felipegaspari/DCO4-REBORN-DCO/docs/AUTOTUNE.md

# Autotune (DCO4-REBORN)

Canonical algorithms and file layout: [`../_shared/docs/AUTOTUNE.md`](../_shared/docs/AUTOTUNE.md).
Operator bring-up: [`../_shared/docs/CALIBRATION_PROCEDURE.md`](../_shared/docs/CALIBRATION_PROCEDURE.md).

This board: **4 voices × 2 oscillators** (8 osc), four PW channels (`cal_pw_channel` = osc / 2), cal-sense **GP10**. Debug cmd 42 is still forwarded to the Mainboard.
