felipegaspari/DCO4-REBORN-DCO/docs/BUILD_FLAGS.md

# DCO Build Flags Catalog

Complete inventory of **live compile-time flags** that change codegen, RAM, IO, or A/B math paths.

- **Deep float/fixed math:** [`ENGINE_OPTIONS.md`](ENGINE_OPTIONS.md)
- **Profiler usage:** [`BENCHMARKING.md`](BENCHMARKING.md)
- **SRAM / heap / stack:** [`MEMORY.md`](MEMORY.md) (`__not_in_flash_func`, dump cmd 13, pin policy)
- **Autotune algorithms:** [`../_shared/docs/AUTOTUNE.md`](../_shared/docs/AUTOTUNE.md)
- **Live source of truth for engine/IO/cal toggles:** top of [`../DCO.ino`](../DCO.ino) before includes

**Override order:** flags set in `DCO.ino` before `#include` win. Header `#ifndef` / library fallbacks apply only when the sketch left them unset.

**Out of scope here:** include guards, X-macro / dirty-bit / note-frequency tables, `_removed/`, MIDI_Library / PID examples. [`../tusb_config.h`](../tusb_config.h) exists but is **not included** (commented in `DCO.ino` / `include_all.h`).

---

## Shipping snapshot

Board defaults in `DCO.ino` differ by MCU (`PICO_RP2350` vs else). The overrides block after that can force either shape.

| Area | RP2350 | RP2040 |
|---|---|---|
| Voice / amp | `USE_FLOAT_VOICE_TASK` + `USE_FLOAT_AMP_COMP` | Fixed (`USE_FLOAT_*` undefined) |
| Pitch | `PITCH_INTERP_FLOAT_FAST` | `PITCH_INTERP_RATIO_Q16` |
| Amp method default | `0` (`FLOAT_QUAD`) | `2` (`FIXED`) |
| Clkdiv | `CLKDIV_FLOAT` | `CLKDIV_Q16` |
| CV outs | Fixed (`USE_FLOAT_CV_OUTS` off) | same |
| Noise | `NOISE_ENGINE 1`, `ENABLE_NOISE_OUT` off | same |
| Autotune | FREQ_TRACE / INTERP / CALC (`AUTOTUNE_*_DEFAULT` = 1) | same |
| ADSR | fixed Q22 phase, micros, native Q15 | same |
| USB panel | `ENABLE_USB_CONTROL` on | same |
| Mainboard UART | `ENABLE_MAINBOARD_LINK` on; `ENABLE_MB_MOD_STREAM` off | same |
| CV / mux / aux HW | off (`ENABLE_CV_OUTS` / `WAVE_MUX` / `VOICE_AUX` commented) — **retained**, unused on this 4×2 board. PW PWM is independent (always live). | same |
| PIO RESET | `ENABLE_PIO_RESET_INVERT` on | same |
| RANGE amp PWM | `RANGE0_PIO_DITHER_TEST` **off** (HW slice; dither not feasible for 8 oscs) | same |
| Profiler (tree as checked in) | `RUNNING_AVERAGE` + `RUNNING_AVERAGE_PERIOD` on; FINE off; `BENCH_STAGE_STRIDE` 1; `BENCH_PERIOD_MAX_US` 20000 | same |
| Mem diag (dump 13) | `ENABLE_MEM_DIAG` on; runtime polls on | same |

Confirm with the `engine:` / `io:` lines in the profiler banner ([`bench.h`](../bench.h)).

---

## 1. [`DCO.ino`](../DCO.ino) — before includes

### 1.1 Engine — pitch mode ids

| Define | Value | Role |
|---|---:|---|
| `PITCH_INTERP_FLOAT` | 0 | Walk-find float interp (needs float voice) |
| `PITCH_INTERP_RATIO_Q16` | 1 | Native Q16 slope path (shipping) |
| `PITCH_INTERP_Q12` | 2 | Legacy ×10000 slope A/B |
| `PITCH_INTERP_FLOAT_FAST` | 3 | Trunc+clamp±1 float find (needs float voice) |

### 1.2 Engine — board defaults (`PICO_RP2350` / else)

| Define | RP2350 | RP2040 | Effect | Consumed |
|---|---|---|---|---|
| `USE_FLOAT_VOICE_TASK` | **on** | off | Compile `voice_task_float` instead of fixed | [`voices.h`](../voices.h) / [`voices.ino`](../voices.ino) |
| `USE_FLOAT_AMP_COMP` | **on** | off | Float amp tables + LUT (`NUM_OSCILLATORS × 7001 × 2` bytes; ~109 KB at 8 osc) dual-build | [`amp_comp.h`](../amp_comp.h), [`FS.ino`](../FS.ino) |
| `AMP_COMP_METHOD_DEFAULT` | `0` (FLOAT_QUAD) | `2` (FIXED) | Initial `amp_comp_method` | [`amp_comp.h`](../amp_comp.h), runtime cmds 20–22 |
| `PITCH_INTERP_MODE` | `PITCH_INTERP_FLOAT_FAST` | `PITCH_INTERP_RATIO_Q16` | Selects one interpolator + its tables | [`voices.ino`](../voices.ino), pitch benches |
| `CLKDIV_MODE` | `CLKDIV_FLOAT` (`1`) | `CLKDIV_Q16` (`2`) | Clkdiv (accuracy order): `0` GOLD (double `llround`); `1` FLOAT (Q24 → float Hz / native Hz on float voice); `2` Q16; `3` Q8 (Q8 32/32+corr); `4` FAST_Q4 (Q4 32/32). Value `0` is GOLD, not old HP0. Value `1` is FLOAT, not old PRECISE_Q8. Both voice engines: fixed via `clkdiv_live_total_cycles`, float via `clkdiv_live_hz_total_cycles`. Cmds 32–33 A/B all five live + GOLD_REF. | `voice_task_fixed_point` / `voice_task_float`, [`clkdiv.h`](../clkdiv.h), [`clkdiv_bench.ino`](../clkdiv_bench.ino) |

`USE_FLOAT_CV_OUTS` is **not** a board default (enable only in overrides). Math detail: [`ENGINE_OPTIONS.md`](ENGINE_OPTIONS.md).

### 1.3 Engine — overrides (commented A/B)

The overrides block is commented in the tree. RP2350 already enables float voice/amp via §1.2; uncomment here to force a path on RP2040 or to A/B clkdiv / pitch / amp method.

| Define | Overrides block | Effect | Consumed |
|---|---|---|---|
| `USE_FLOAT_VOICE_TASK` | commented | Compile `voice_task_float` instead of fixed | [`voices.h`](../voices.h) / [`voices.ino`](../voices.ino) |
| `USE_FLOAT_AMP_COMP` | commented | Float amp tables + LUT (`NUM_OSCILLATORS × 7001 × 2` bytes; ~109 KB at 8 osc) dual-build | [`amp_comp.h`](../amp_comp.h), [`FS.ino`](../FS.ino) |
| `USE_FLOAT_CV_OUTS` | commented | Float VCA/VCF/keytrack/drift path | [`cv_out.ino`](../cv_out.ino), [`cv_state.h`](../cv_state.h) |

Pitch A/B: `#undef PITCH_INTERP_MODE` then redefine. Guard: `FLOAT` / `FLOAT_FAST` without float voice → `#error`.

### 1.4 Noise

| Define | Shipping | Effect | Consumed |
|---|---|---|---|
| `NOISE_ENGINE` | `1` (FastNoiseGen) | Which `DcoNoiseGen` implementation | [`noise.h`](../noise.h), [`DCO_Noise.h`](../_build_libs/DCO_Noise/DCO_Noise.h) |
| `ENABLE_NOISE_OUT` | off | PIO1 LFSR 1-bit white on GP2 | DCO_Noise, [`state_machines.ino`](../state_machines.ino) |

`NOISE_ENGINE` values: `0` ColoredNoise, `1` FastNoiseGen, `2` PrimeHybridNoise, `3` ProNoise32.

### 1.5 Profiling / bench

| Define | Shipping | Effect | Consumed |
|---|---|---|---|
| `RUNNING_AVERAGE` | **on** | Hot-path profiler (`bench.h`); paced `bench_out_*` | [`bench.h`](../bench.h), benches |
| `RUNNING_AVERAGE_FINE` | off | Extra tiny-stage probes (opt barrier) | `BENCH_FBEGIN` / `FEND` |
| `RUNNING_AVERAGE_PERIOD` | **on** | Period probes only; stage probes compile out; overrides FINE | `bench.h` |
| `BENCH_STAGE_STRIDE` | `1` | MAIN/FINE stage probes every Nth loop (`1` = every iter); note-on always; needs `RUNNING_AVERAGE` | [`bench.h`](../bench.h), [`DCO.ino`](../DCO.ino) |
| `BENCH_USE_SYSTICK` | `1` | SysTick for PERIOD + stages; `0` → 1 µs timer for all probes. Dump window still 1 µs. | [`bench.h`](../bench.h), [`DCO.ino`](../DCO.ino) |
| `BENCH_PERIOD_MAX_US` | `20000` | Discard PERIOD samples longer than this (autotune / wrap-looking stalls) | [`bench.h`](../bench.h), [`DCO.ino`](../DCO.ino) |
| `BENCH_PATH_STATS` | off | All path bumps + `-- Path counters --` dump; needs `RUNNING_AVERAGE`; no-op under PERIOD | [`bench.h`](../bench.h), [`voices.ino`](../voices.ino) |
| `AMP_COMP_BENCHMARK` | off | Amp speed/accuracy cmds 24–25; needs `RUNNING_AVERAGE` + `USE_FLOAT_AMP_COMP` | [`amp_comp_bench.ino`](../amp_comp_bench.ino) |
| `ENABLE_MEM_DIAG` | **on** | Cmd 13 RAM dump + `loop`/`loop1` polls; comment out = empty inlines. Runtime 14/15 disable/enable polls | [`mem_diag.h`](../mem_diag.h), [`MEMORY.md`](MEMORY.md) |

Pitch interp cmds **28–29** and fixed clkdiv cmds **32–33** (`CLKDIV_MODE` A/B) need `RUNNING_AVERAGE` only (no extra flag): [`pitch_interp_bench.ino`](../pitch_interp_bench.ino), [`clkdiv_bench.ino`](../clkdiv_bench.ino).

### 1.6 Calibration (auto-cal boot defaults)

Set in `DCO.ino` before includes. Enums and `#ifndef` fallbacks live in [`_shared/autotune.h`](../_shared/autotune.h). Algorithms: [`../_shared/docs/AUTOTUNE.md`](../_shared/docs/AUTOTUNE.md).

| Define | Shipping | Effect | Consumed |
|---|---|---|---|
| `AUTOTUNE_AMP_METHOD_DEFAULT` | `1` (FREQ_TRACE) | Amp-comp calibration search: `0` CLASSIC (per-note range-PWM search), `1` FREQ_TRACE (fixed-PWM frequency bisection from the manual 440 Hz anchor). Runtime 34/35 (panel Calibration tab); reported as `amp_cal=` on the profiler `engine:` line. Header fallback is `0` if this is unset. | [`DCO.ino`](../DCO.ino), [`_shared/autotune.h`](../_shared/autotune.h) |
| `AUTOTUNE_SEARCH_MODE_DEFAULT` | `1` (INTERP) | How the frequency search closes in once it has a bracket: `0` BISECT, `1` INTERP, `2` GATED. Runtime 37/38/39. Header fallback is also `1`. | [`DCO.ino`](../DCO.ino), [`_shared/autotune.h`](../_shared/autotune.h) |
| `AUTOTUNE_AMP0_MODE_DEFAULT` | `1` (CALC) | Amp-comp-0 endpoint (pair 0): `0` MEASURE (live hunt), `1` CALC (bottom-rung fit). Runtime 40/41. Header fallback is `0` if this is unset. | [`DCO.ino`](../DCO.ino), [`_shared/autotune.h`](../_shared/autotune.h) |

### 1.7 Board / IO

| Define | Shipping | Effect | Consumed |
|---|---|---|---|
| `ENABLE_MAINBOARD_LINK` | **on** | Serial2 GP20/21 peers with the STM32 Mainboard (`'n'`/`'o'`/`'e'`/`'x'`/`'p'` TX; slim `'p'` RX) | [`Serial.h`](../Serial.h) / [`Serial.ino`](../Serial.ino) |
| `ENABLE_MB_MOD_STREAM` | **off** | Consume Mainboard `'m'` and skip local LFO1/2 + EnvDCO clocks. Default off: DCO runs LFO1/2, envelopes, and matrix→pitch locally. | [`Serial.ino`](../Serial.ino), [`voices.ino`](../voices.ino), [`DCO.ino`](../DCO.ino) `loop()` |
| `ENABLE_USB_CONTROL` | **on** | Panel protocol on USB CDC (`dco_control`) | [`Serial.h`](../Serial.h) / [`Serial.ino`](../Serial.ino), bench TX |
| `SERIAL_FRAMING_COBS` | **off** | On-wire COBS(`inner`)+`0x00` instead of RAW inner. A/B vs default; host: `dco_control --cobs` or `DCO_SERIAL_COBS=1`. | [`serial_frame.h`](../serial_frame.h) / [`serial_parser.h`](../serial_parser.h), [`DCO.ino`](../DCO.ino) |
| `ENABLE_CV_OUTS` | off | Cut/Res/VCA/dist/levels PWM writers — unused on this project; keep for expansion. PW is not behind this flag. | [`PWM.ino`](../PWM.ino), [`cv_out.ino`](../cv_out.ino), [`globals.h`](../globals.h) pins |
| `ENABLE_WAVE_MUX` | off | Wave mux GPIO / shift-register — unused on this project; keep for expansion | globals pin block, wave mux |
| `ENABLE_VOICE_AUX` | off | Skip local Dist/filter writers (aux owns them) | [`PWM.ino`](../PWM.ino), globals |
| `ENABLE_PIO_RESET_INVERT` | **on** | Active-low RESET pad via GPIO OVER | [`state_machines.ino`](../state_machines.ino) |
| `RANGE0_PIO_DITHER_TEST` | **off** | Comment out = HW slice `wrap=DIV_COUNTER` on all 8 `RANGE_PINS[]`. Define = PIO dither (not used on 4×2). | [`PWM.h`](../PWM.h) / [`PWM.ino`](../PWM.ino), [`_shared/autotune_impl.h`](../_shared/autotune_impl.h), `setup1()` |
| `NOTE_RETRIG_MODE_DEFAULT` | `0` (EXACT_Y) | Note-on sync retrig default; runtime 26/27 | [`globals.h`](../globals.h) |

---

## 2. [`adsr.h`](../adsr.h) → [`ADSR_Bezier.h`](../_build_libs/ADSR_Bezier/ADSR_Bezier.h)

Sketch sets these **before** including the library (library has its own fallbacks).

| Define | DCO shipping | Library fallback if unset | Effect |
|---|---:|---|---|
| `ADSR_BEZIER_PHASE_SHIFT` | `22` | `22` | `22` = uint32 phase; `>22` (e.g. 24) = uint64 phase |
| `ADSR_BEZIER_USE_FLOAT` | `0` | `0` | `1` = float time index (soft-float on RP2040) |
| `ADSR_BEZIER_USE_MICROS` | `1` | `1` | `1` micros / `0` millis timebase |
| `ADSR_BEZIER_NATIVE_Q15` | `1` | **`0`** | `1` = primary amp domain Q15; `0` = DAC-primary + optional cache |
| `ADSR_BEZIER_Q15_DYADIC` | `1` | `1` | NATIVE=1: peak 32768 vs 32767 A/B |
| `ADSR_BEZIER_UPDATE_Q15_CACHE` | `1` | `1` | Refresh Q15 in `getWave`; ignored when NATIVE=1 |
| `ADSR_BEZIER_SRAM_HOT` | **`1`** | **`0`** | `1` = RP2040 `__not_in_flash_func` on `getWave` / `noteOn` / `noteOff` (static SRAM, not heap — [`MEMORY.md`](MEMORY.md)) |

Derived: `ADSR_BEZIER_PHASE_SCALE_U64` (`1` when shift > 22).

---

## 3. [`LFO.h`](../LFO.h) → [`mo-lfo.h`](../_build_libs/mo-lfo/mo-lfo.h)

| Define | DCO shipping | Library fallback if unset | Effect |
|---|---:|---|---|
| `MO_LFO_USE_Q15` | `1` | **`0`** | Preferred-path hint / pragma only; API always has `getWave` + `getWaveQ15` |
| `MO_LFO_SRAM_HOT` | **`1`** | **`0`** | `1` = RP2040 `__not_in_flash_func` on `getWaveQ15` + `_advanceUnitQ15` (static SRAM — [`MEMORY.md`](MEMORY.md)) |
| `LFO_SINE_TABLE_BITS` | `9` | `9` (in mo-lfo if unset) | Sine LUT size `1<<bits` |

---

## 4. [`globals.h`](../globals.h)

### Feature flags

| Define | Shipping | Effect | Consumed |
|---|---|---|---|
| `ENABLE_FS_CALIBRATION` | **on** | Load LittleFS `voiceTables` / PW cal into amp-comp | [`FS.ino`](../FS.ino) |
| `NOTE_RETRIG_MODE_DEFAULT` | `0` if unset | Fallback if `DCO.ino` omitted it | `note_retrig_mode` |
| `USE_ADC_STACK_VOICES` | commented | Legacy ADC stack voices (GPIO 28) | unused when commented |
| `USE_ADC_DETUNE` | commented | Legacy ADC detune (GPIO 27) | unused when commented |

**LittleFS flash partition:** presets (`pb00`…`pb63`, 4 records × 598 B per chunk) plus
calibration files need a filesystem slice. The default
`rp2040:rp2040:rpipico2:usbstack=tinyusb` FQBN often allocates **no** FS space.
Compile/upload with an explicit size that includes one, e.g.:

```bash
arduino-cli compile \
  --fqbn rp2040:rp2040:rpipico2:usbstack=tinyusb,flash=4194304_524288 \
  --libraries ./_build_libs \
  .
```

(`4194304_524288` = 4 MB flash, 512 KB LittleFS — sized for a full 256-slot bank at
4 records/file.) Without that, `init_FS()` / preset save fail at runtime. Changing the
FS size moves `_FS_start`/`_FS_end` and **reformats the filesystem** — back up
calibration + presets with `tools/dco_control` first, restore after. Preset
protocol: [`PRESET_STORE.md`](PRESET_STORE.md).

Comment-only (not a live define): `ENABLE_PIO_MIDI` — PIO2 reserved in comments / [`PINOUT.md`](PINOUT.md); not compiled today.

### Capacity constants (not feature toggles)

| Define | Value | Role |
|---|---:|---|
| `NUM_VOICES_TOTAL` | 4 | MIDI voice-slot capacity (ADSR / flags / PW) |
| `NUM_OSCILLATORS` | 8 | Physical DCOs (2 per voice) |
| `NUM_PW_CHANNELS` | 4 (`NUM_VOICES_TOTAL`) | PW PWM channels; `cal_pw_channel(osc)` = osc / 2 |
| `NUM_FILTERS` | 2 (`#ifndef`) | Filter count (also defaulted in `cv_out.h` / `PWM.h` / `cv_state.h`) |
| `MIDI_CHANNEL` | 1 | Default MIDI channel |

---

## 5. Other live headers

| File | Define | Shipping | Effect |
|---|---|---|---|
| [`noise.h`](../noise.h) | `NOISE_ENGINE` | fallback `0` if sketch omit | DCO sets `1` in `DCO.ino` |
| [`bench.h`](../bench.h) | `BENCH_USE_SYSTICK` / `BENCH_PERIOD_MAX_US` | sketch wins | Header `#ifndef` fallbacks only if unset in [`DCO.ino`](../DCO.ino) |
| [`amp_comp.h`](../amp_comp.h) | `AMP_COMP_METHOD_DEFAULT` | fallback `AMP_COMP_FIXED` | Only if unset before include |
| [`_shared/autotune.h`](../_shared/autotune.h) | `AUTOTUNE_AMP_METHOD_DEFAULT` / `SEARCH` / `AMP0` | sketch wins (`1`/`1`/`1`); header fallback `0`/`1`/`0` | Only if unset before include |
| [`voices.ino`](../voices.ino) | `DCO_DEBUG_REPORT` | `0` | `1` = serial dump of OSC1 frequency stages |

Headers that only **consume** flags (no new feature `#define`): `voices.h`, `cv_state.h`, `cv_out.h`, `PWM.h`, `Serial.h`, `FS.h`, `mod_matrix.h`, `include_all.h`, etc.

---

## 6. Vendored library notes

| Library | Flag interaction |
|---|---|
| ADSR_Bezier | Defaults differ on `NATIVE_Q15` (`0` in lib vs `1` in DCO) and `SRAM_HOT` (`0` vs `1`). Always set via [`adsr.h`](../adsr.h). |
| mo-lfo | `MO_LFO_USE_Q15` / `MO_LFO_SRAM_HOT` lib default `0`; DCO forces `1` in [`LFO.h`](../LFO.h). |
| DCO_Noise | Reads `NOISE_ENGINE` / `ENABLE_NOISE_OUT`; fallback engine `0`. |

---

## 7. Where to change what

| Goal | Where |
|---|---|
| Float/fixed voice, pitch, amp, CV, HP clkdiv | `DCO.ino` **ENGINE — overrides** (and board defaults for MCU policy) |
| Autotune method / search / amp-0 boot defaults | `DCO.ino` **CALIBRATION** block (`AUTOTUNE_*_DEFAULT`) |
| Noise engine / PIO white pin | `DCO.ino` noise block |
| Profiler on/off / period-only | `DCO.ino` profiling block |
| USB panel / Mainboard UART / CV HW / aux / RESET invert | `DCO.ino` BOARD / IO |
| ADSR phase / native Q15 / SRAM hot A/B | [`adsr.h`](../adsr.h) before library include |
| LFO Q15 hint / SRAM hot / sine table bits | [`LFO.h`](../LFO.h) |
| Heap / stack / RAM-text dump | Diagnostics cmd **13**; polls flag `ENABLE_MEM_DIAG` + runtime 14/15 — [`MEMORY.md`](MEMORY.md) |
| FS cal load | [`globals.h`](../globals.h) `ENABLE_FS_CALIBRATION` |
| OSC1 debug prints | [`voices.ino`](../voices.ino) `DCO_DEBUG_REPORT` |

After flag changes: clean rebuild; confirm LittleFS amp-comp load; listen low notes + amp plateau; optional profiler dump (cmd **10**) — see [`BENCHMARKING.md`](BENCHMARKING.md).
