felipegaspari/DCO4-REBORN-DCO/docs/CALIBRATION_PROCEDURE.md

# Calibration procedure (DCO4-REBORN)

Canonical operator workflow: [`../_shared/docs/CALIBRATION_PROCEDURE.md`](../_shared/docs/CALIBRATION_PROCEDURE.md).
Algorithms: [`../_shared/docs/AUTOTUNE.md`](../_shared/docs/AUTOTUNE.md).

This board: oscillators **0..7**, four PW channels, cal-sense **GP10**.
