felipegaspari/DCO4-REBORN-DCO/docs/schematics/distortion/distortion.pdf

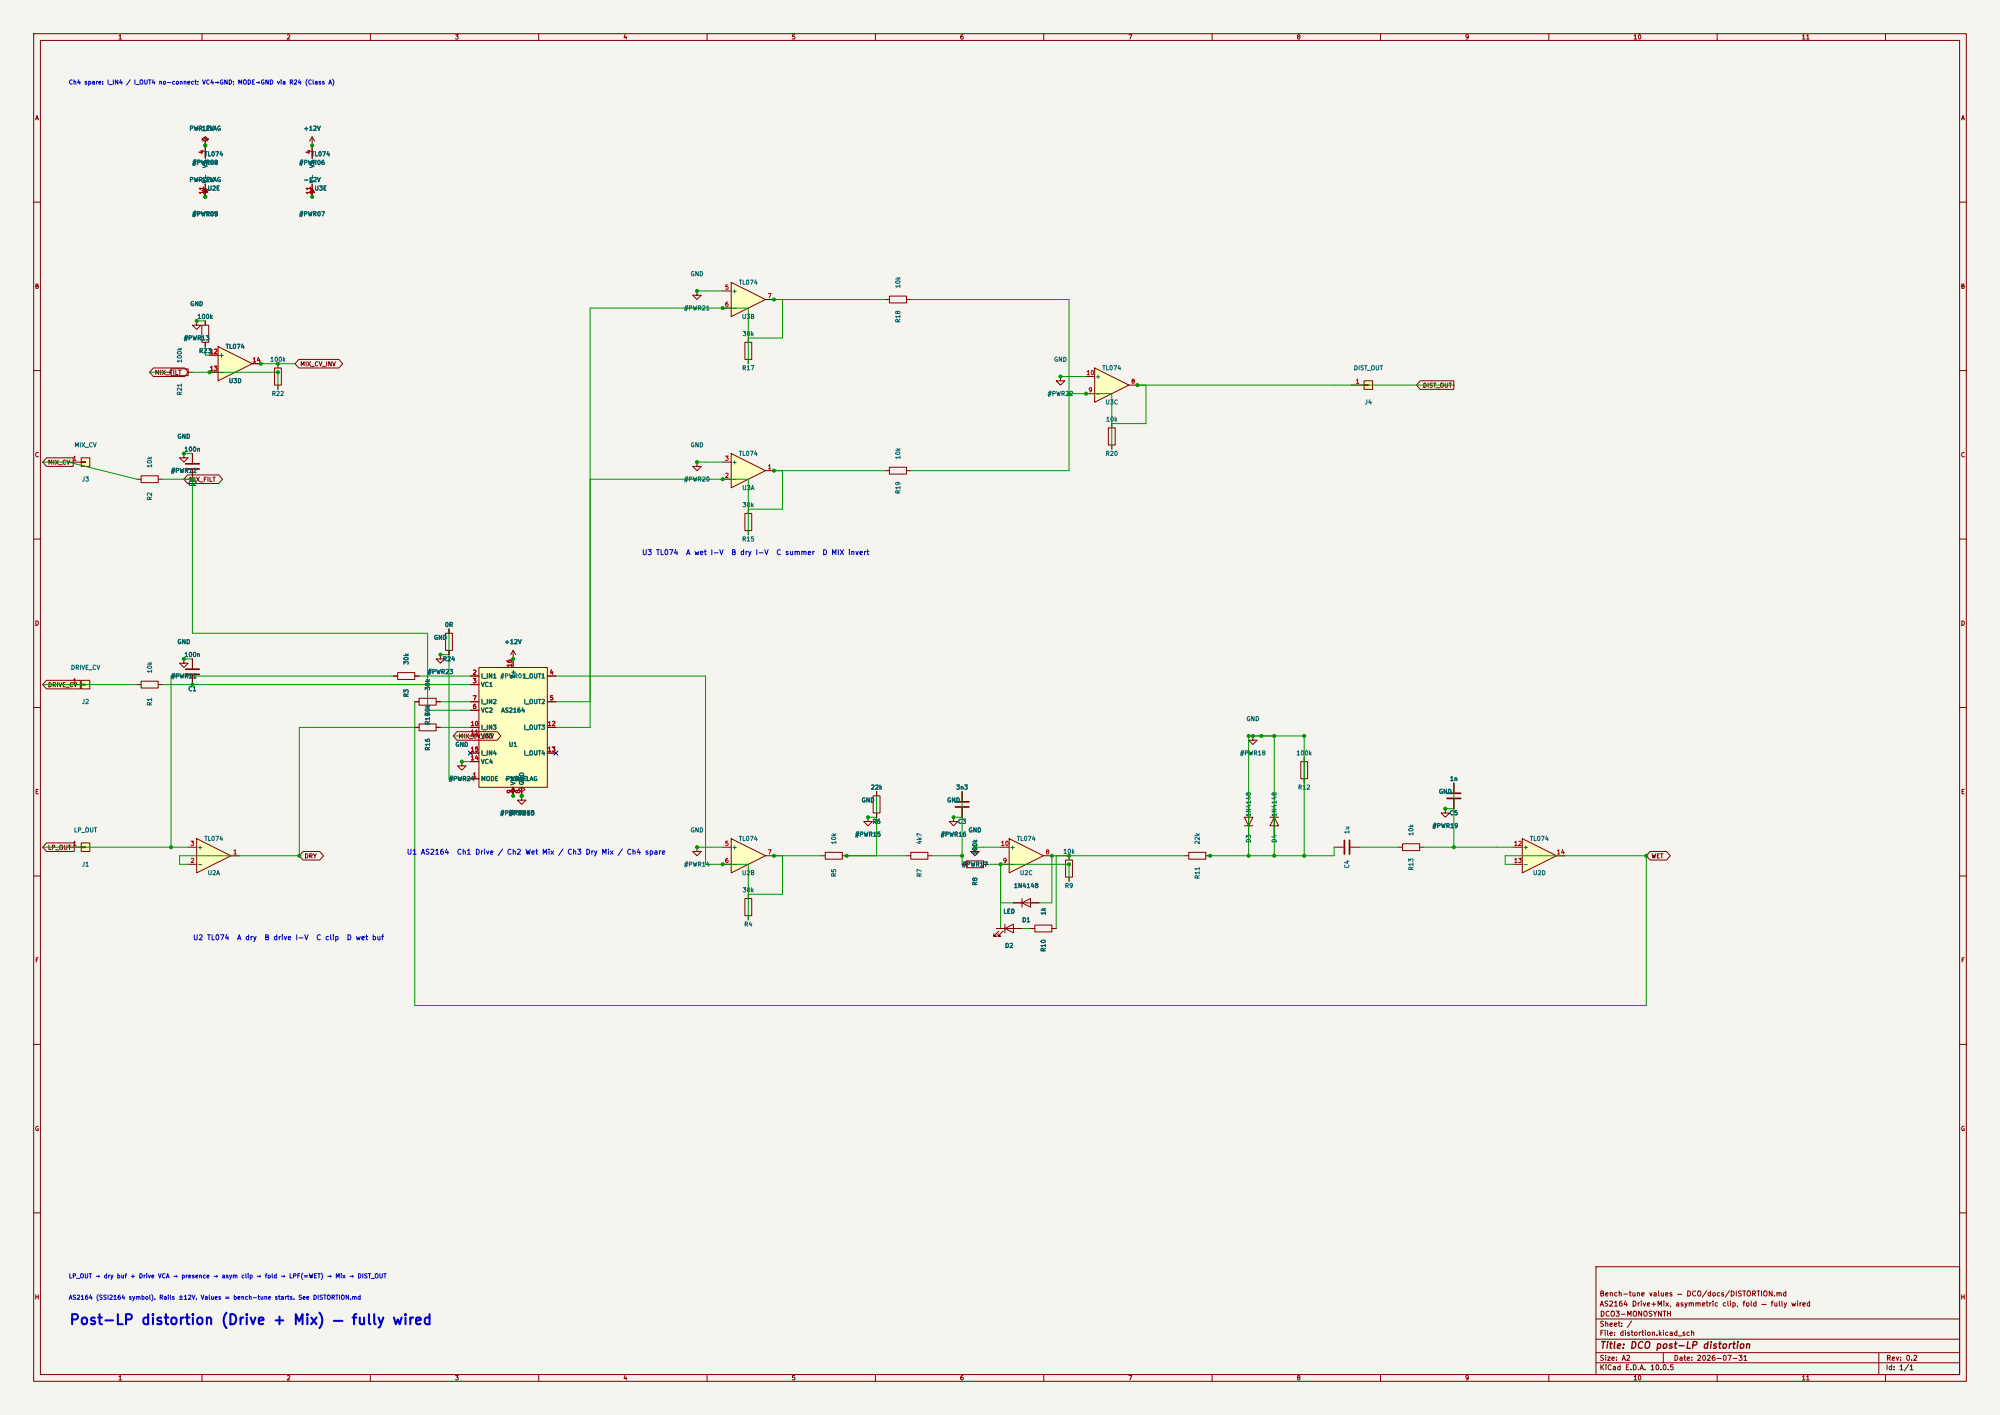
[picture p2: page 1]

Ch4 spare: I_IN4 / I_OUT4 no-connect; VC4→GND; MODE→GND via R24 (Class A)

U1 AS2164 Ch1 Drive / Ch2 Wet Mix / Ch3 Dry Mix / Ch4 spare

LP_OUT → dry buf + Drive VCA → presence → asym clip → fold → LPF(=WET) → Mix → DIST_OUT U2 TL074 A dry B drive I-V C clip D wet buf

AS2164 (SSI2164 symbol). Rails ±12V. Values = bench-tune starts. See DISTORTION.md
Post-LP distortion (Drive + Mix) — fully wired

Bench-tune values — DCO/docs/DISTORTION.md
AS2164 Drive+Mix, asymmetric clip, fold — fully wired
DCO3-MONOSYNTH
Sheet: /
File: distortion.kicad_sch
Title: DCO post-LP distortion

Size: A2 | Rev: 0.2
KiCad E.D.A. 10.0.5 | Id: 1/1
