felipegaspari/DCO4-REBORN-DCO/docs/schematics/distortion/distortion.kicad_sch

## KiCad design docs/schematics/distortion/distortion.kicad_sch (2026-08-01)

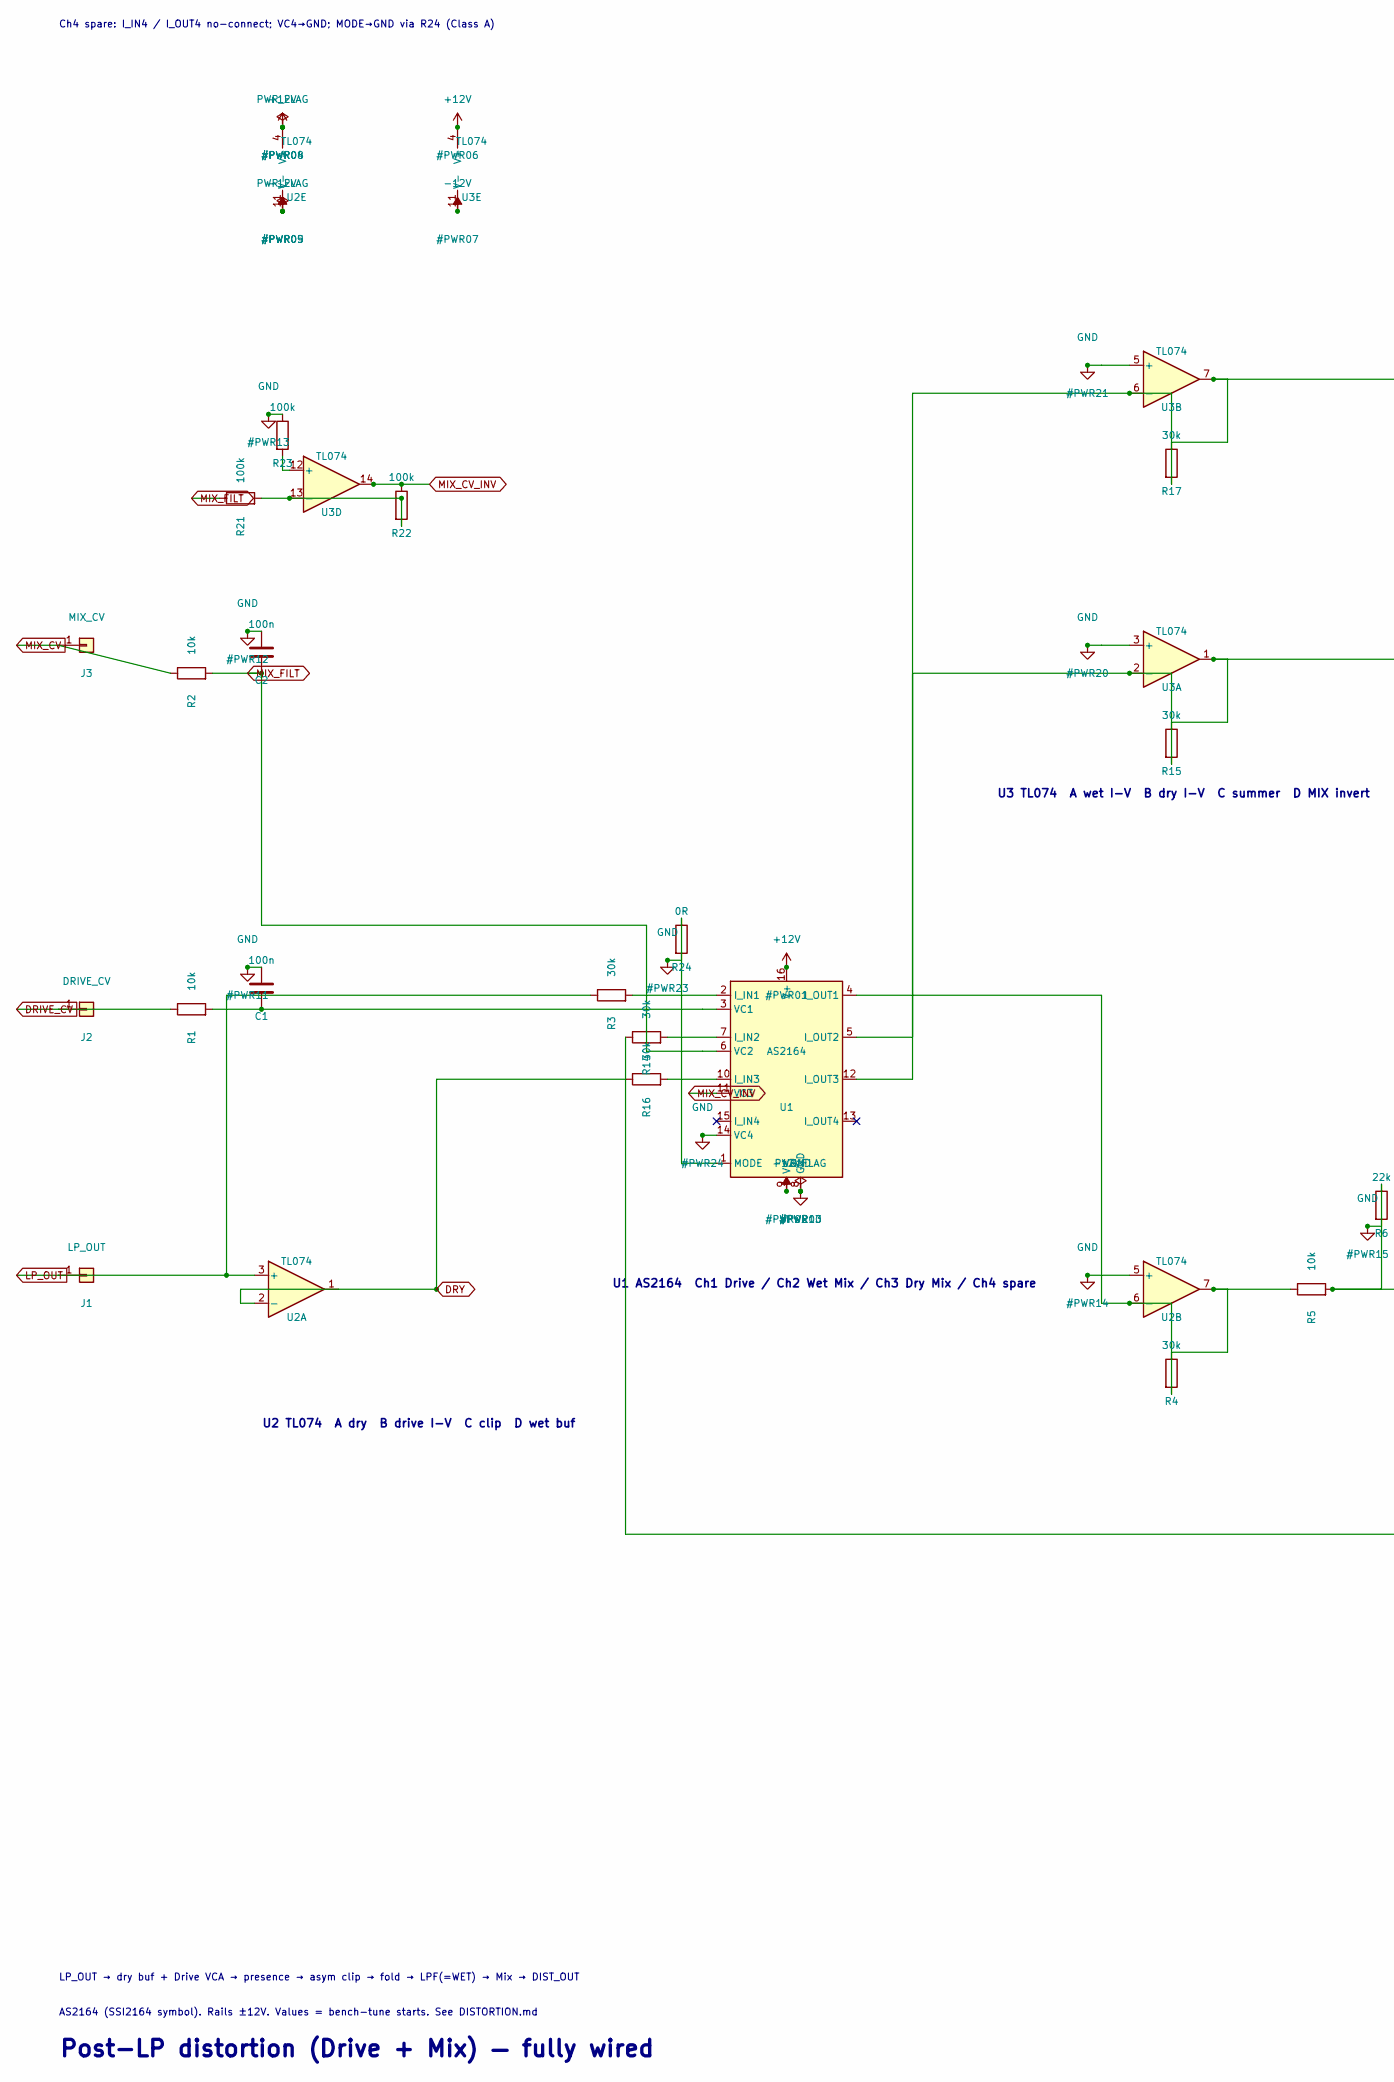
[picture p3: schematic distortion.kicad_sch, part in row 1, column 1]

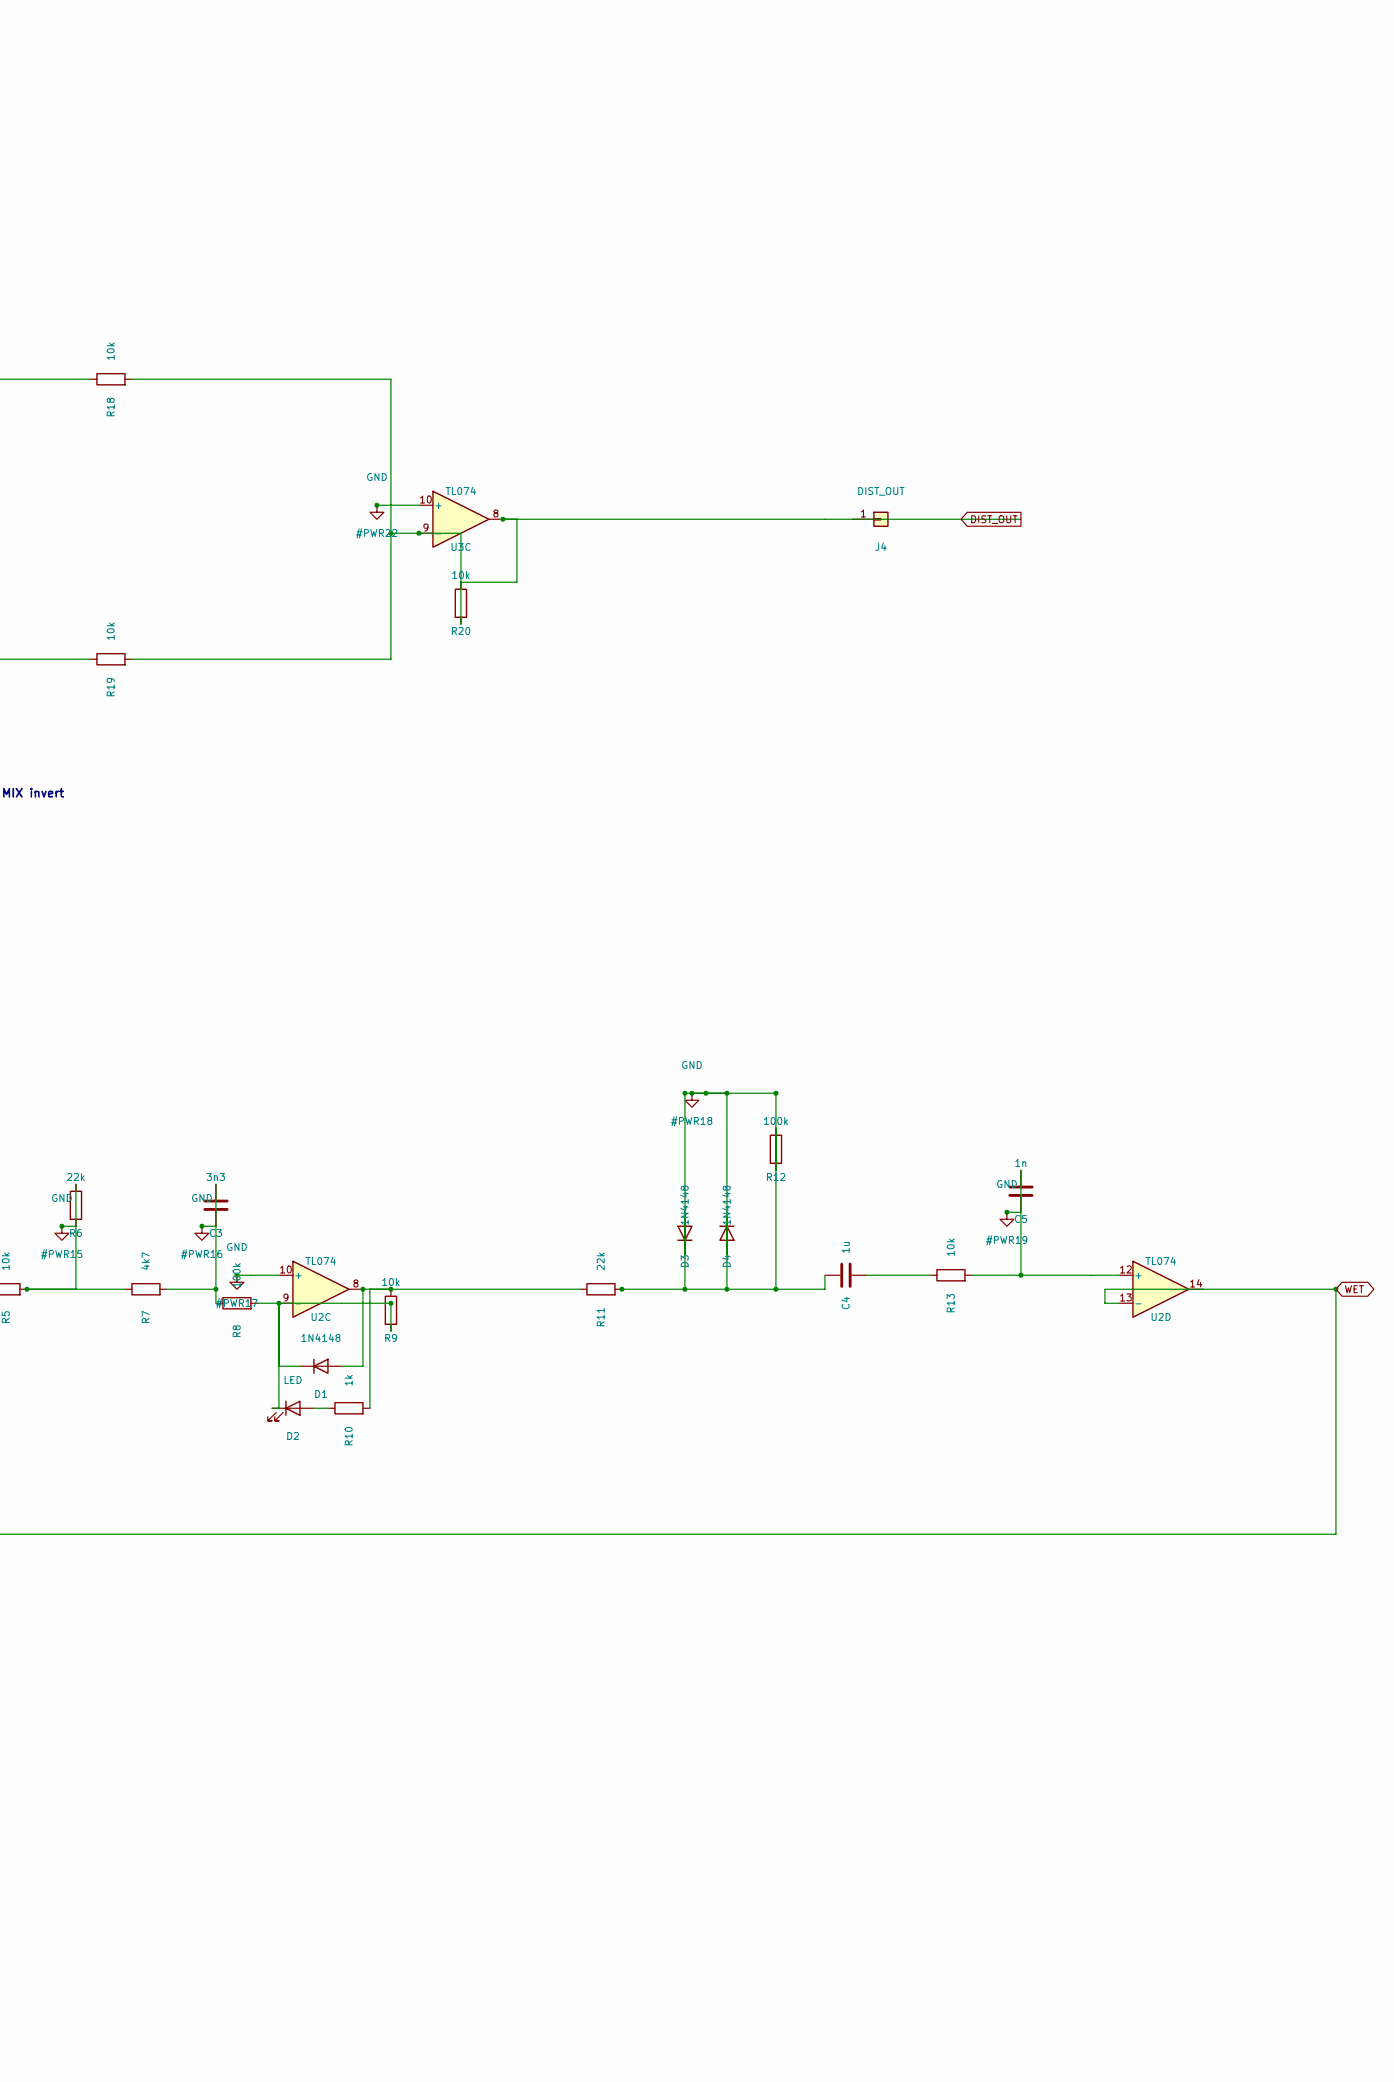
[picture p4: schematic distortion.kicad_sch, part in row 1, column 2]

Parts:
C1, C2: 100n
C3: 3n3
C4: 1u
C5: 1n
D1, D3, D4: 1N4148
D2: LED
J1: LP_OUT
J2: DRIVE_CV
J3: MIX_CV
J4: DIST_OUT
R1, R2, R5, R9, R13, R18, R19, R20: 10k
R3, R4, R14, R15, R16, R17: 30k
R6, R11: 22k
R7: 4k7
R8, R12, R21, R22, R23: 100k
R10: 1k
R24: 0R
U1: AS2164
U2, U3: TL074

Connections:
+12V: C1.1, C2.1, C3.2, C5.2, D3.1 (K), D4.2 (A), R6.2, R12.2, R23.1, R24.2, U1.8 (GND), U1.9 (V-), U1.14 (VC4), U1.16 (V+), U2.4 (V+), U2.5 (+), U2.10 (+), U2.11 (V-), U3.3 (+), U3.4 (V+), U3.5 (+), U3.10 (+), U3.11 (V-)
DIST_OUT: J4.1, R20.1, U3.8
DRIVE_CV: J2.1, R1.1
DRY: R16.1, U2.1, U2.2 (-)
LP_OUT: J1.1, R3.1, U2.3 (+)
MIX_CV: J3.1, R2.1
MIX_CV_INV: R22.1, U1.11 (VC3), U3.14
MIX_FILT: C2.2, R2.2, R21.1, U1.6 (VC2)
unnamed: C1.2, R1.2, U1.3 (VC1)
unnamed: C3.1, R7.2, R8.1
unnamed: C4.1, D3.2 (A), D4.1 (K), R11.2, R12.1
unnamed: C4.2, R13.1
unnamed: C5.1, R13.2, U2.12 (+)
unnamed: D1.1 (K), D2.1 (K), R8.2, R9.2, U2.9 (-)
unnamed: D1.2 (A), R9.1, R10.2, R11.1, U2.8
unnamed: D2.2 (A), R10.1
unnamed: R3.2, U1.2 (I_IN1)
unnamed: R4.1, R5.1, U2.7
unnamed: R4.2, U1.4 (I_OUT1), U2.6 (-)
unnamed: R5.2, R6.1, R7.1
unnamed: R14.2, U1.7 (I_IN2)
unnamed: R15.1, R19.1, U3.1
unnamed: R15.2, U1.5 (I_OUT2), U3.2 (-)
unnamed: R16.2, U1.10 (I_IN3)
unnamed: R17.1, R18.1, U3.7
unnamed: R17.2, U1.12 (I_OUT3), U3.6 (-)
unnamed: R18.2, R19.2, R20.2, U3.9 (-)
unnamed: R21.2, R22.2, U3.13 (-)
unnamed: R23.2, U3.12 (+)
unnamed: R24.1, U1.1 (MODE)
WET: R14.1, U2.13 (-), U2.14

Notes on the sheet:
Post-LP distortion (Drive + Mix) — fully wired
AS2164 (SSI2164 symbol). Rails ±12V. Values = bench-tune starts. See DISTORTION.md
LP_OUT → dry buf + Drive VCA → presence → asym clip → fold → LPF(=WET) → Mix → DIST_OUT
U1 AS2164 Ch1 Drive / Ch2 Wet Mix / Ch3 Dry Mix / Ch4 spare
U2 TL074 A dry B drive I-V C clip D wet buf
U3 TL074 A wet I-V B dry I-V C summer D MIX invert
Ch4 spare: I_IN4 / I_OUT4 no-connect; VC4→GND; MODE→GND via R24 (Class A)
