felipegaspari/DCO4-REBORN-DCO/voices.ino

#include "include_all.h"
#include <limits.h>
#include <math.h>
#include "clkdiv.h"

// Enable/disable detailed DCO debug report (including OSC1 frequency stages)
#define DCO_DEBUG_REPORT 0

static inline void amp_chan_levels_fixed(int64_t freq_q24_A, int64_t freq_q24_B,
                                  uint8_t oscA, uint8_t oscB,
                                  uint16_t *outA, uint16_t *outB);

static inline __attribute__((always_inline)) void voice_write_pw(uint8_t voice, uint16_t level) {
  if (PW_PINS[voice] == PW_PIN_UNASSIGNED) return;
  pwm_set_chan_level(PW_PWM_SLICES[voice], pwm_gpio_to_channel(PW_PINS[voice]), level);
}

static inline __attribute__((always_inline)) void voice_write_range_pair(uint8_t dcoA, uint8_t dcoB,
                                          uint16_t chanA, uint16_t chanB) {
  if (char_amp_scale_q15) {
    const int32_t amp_j = character_amp_delta();
    write_range_pwm(dcoA, character_clamp_amp((int32_t)chanA + amp_j));
    write_range_pwm(dcoB, character_clamp_amp((int32_t)chanB + amp_j));
  } else {
    write_range_pwm(dcoA, chanA);
    write_range_pwm(dcoB, chanB);
  }
}
#if PITCH_INTERP_MODE == PITCH_INTERP_RATIO_Q16
int32_t interpolateRatioQ16_cached(int32_t xQ16, int dcoIndex);
#endif
#if PITCH_INTERP_MODE == PITCH_INTERP_Q12
int32_t interpolatePitchMultiplierIntQ16_cached(int32_t xQ16, int dcoIndex);
#endif
#if PITCH_INTERP_MODE == PITCH_INTERP_FLOAT
float interpolateRatioFloat_cached(float x, int dcoIndex);
#endif
#if PITCH_INTERP_MODE == PITCH_INTERP_FLOAT_FAST
float interpolateRatioFloat_cached_fast(float x, int dcoIndex);
#endif

// Live pitch interp: compile-time wrappers (always_inline; not function pointers).
// Fixed-voice wrappers only — float voice uses interpolate_live_ratio_f (FLOAT_FAST would
// otherwise type-check the Q12 #else and fail: IntQ16 is not compiled).
#ifndef USE_FLOAT_VOICE_TASK
static inline __attribute__((always_inline)) int32_t modifiers_q24_to_xQ16(int64_t modifiers_q24) {
#if PITCH_INTERP_MODE == PITCH_INTERP_RATIO_Q16
  return (modifiers_q24 >= 0) ? (int32_t)(modifiers_q24 >> 8)
                              : (int32_t)(-((-modifiers_q24) >> 8));
#else
  int64_t x_q24s = modifiers_q24 * (int64_t)multiplierTableScale;
  return (x_q24s >= 0) ? (int32_t)(x_q24s >> 8) : (int32_t)(-((-x_q24s) >> 8));
#endif
}

static inline __attribute__((always_inline)) int32_t interpolate_live_ratio_q16(int32_t xQ16, int dcoIndex) {
#if PITCH_INTERP_MODE == PITCH_INTERP_RATIO_Q16
  return interpolateRatioQ16_cached(xQ16, dcoIndex);
#elif PITCH_INTERP_MODE == PITCH_INTERP_Q12
  int32_t yTab = interpolatePitchMultiplierIntQ16_cached(xQ16, dcoIndex);
  uint64_t num = ((uint64_t)(uint32_t)yTab << 16) + 5000u;
  return (int32_t)((num * 0xD1B71759ULL) >> 45);
#else
#error "interpolate_live_ratio_q16: PITCH_INTERP_FLOAT / FLOAT_FAST require USE_FLOAT_VOICE_TASK"
#endif
}
#endif  // !USE_FLOAT_VOICE_TASK

static inline __attribute__((always_inline)) float interpolate_live_ratio_f(float modifiers, int dcoIndex) {
#if PITCH_INTERP_MODE == PITCH_INTERP_FLOAT
  return interpolateRatioFloat_cached(modifiers, dcoIndex);
#elif PITCH_INTERP_MODE == PITCH_INTERP_FLOAT_FAST
  return interpolateRatioFloat_cached_fast(modifiers, dcoIndex);
#elif PITCH_INTERP_MODE == PITCH_INTERP_RATIO_Q16
  int32_t xQ16 = (int32_t)lroundf(modifiers * 65536.0f);
  return (float)interpolateRatioQ16_cached(xQ16, dcoIndex) * (1.0f / 65536.0f);
#else
  float x = modifiers * (float)multiplierTableScale;
  int32_t xQ16 = (int32_t)lroundf(x * 65536.0f);
  return (float)interpolatePitchMultiplierIntQ16_cached(xQ16, dcoIndex)
         / (float)multiplierTableScale;
#endif
}

// Boot init: seed notes, build pitch tables, apply voice mode, run one voice_task_main().
void init_voices() {
  for (int i = 0; i < NUM_VOICES_TOTAL; i++) {
    VOICE_NOTES[i] = DCO_calibration_start_note;
    VOICES[i] = 0;
  }

#ifdef ENABLE_MB_MOD_STREAM
  // ADSR_update() bails out early on this build and never refreshes the levels,
  // so the allocator estimates a release tail from the time instead (see
  // voice_alloc()).
  voiceAlloc.begin();
#else
  voiceAlloc.begin(ADSR_VCA_Level_q15);
#endif

  initMultiplierTables();
  setVoiceMode();
  voice_task_main();
}

// Fast helper: convert a Q16 note (semitones) to Q24 frequency using linear
// interpolation on the sNotePitches_q24 table. Used in slew-rate mode.
static inline int64_t noteQ16_to_freqQ24(int32_t note_q16) {
  const size_t NOTE_TABLE_LEN = sizeof(sNotePitches_q24) / sizeof(sNotePitches_q24[0]);
  if (NOTE_TABLE_LEN == 0) return 0;

  int32_t noteInt = note_q16 >> 16;
  uint32_t frac = (uint32_t)note_q16 & 0xFFFF;

  if (noteInt <= 0) {
    if (NOTE_TABLE_LEN == 1) return sNotePitches_q24[0];
    if (frac == 0) return sNotePitches_q24[0];
    int64_t f0 = sNotePitches_q24[0];
    int64_t f1 = sNotePitches_q24[1];
    int64_t df = f1 - f0;
    return f0 + ((df * (int64_t)frac) >> 16);
  }
  if ((size_t)noteInt >= NOTE_TABLE_LEN - 1) {
    // Clamp to top of table
    return sNotePitches_q24[NOTE_TABLE_LEN - 1];
  }

  if (frac == 0) {
    // Exact semitone, just return table entry (common case).
    return sNotePitches_q24[noteInt];
  }

  int64_t f0 = sNotePitches_q24[noteInt];
  int64_t f1 = sNotePitches_q24[noteInt + 1];
  int64_t df = f1 - f0;
  return f0 + ((df * (int64_t)frac) >> 16);
}

// Inverse of noteQ16_to_freqQ24: Q24 Hz → Q16 note via binary search + linear frac.
static inline int32_t freqQ24_to_noteQ16(int64_t freq_q24) {
  const size_t NOTE_TABLE_LEN = sizeof(sNotePitches_q24) / sizeof(sNotePitches_q24[0]);
  if (NOTE_TABLE_LEN == 0) return 0;
  if (NOTE_TABLE_LEN == 1) return 0;
  if (freq_q24 <= sNotePitches_q24[0]) return 0;
  if (freq_q24 >= sNotePitches_q24[NOTE_TABLE_LEN - 1]) {
    return ((int32_t)(NOTE_TABLE_LEN - 1)) << 16;
  }

  size_t lo = 0;
  size_t hi = NOTE_TABLE_LEN - 1;
  while (hi - lo > 1) {
    size_t mid = lo + ((hi - lo) >> 1);
    if (sNotePitches_q24[mid] <= freq_q24) {
      lo = mid;
    } else {
      hi = mid;
    }
  }

  int64_t f0 = sNotePitches_q24[lo];
  int64_t f1 = sNotePitches_q24[hi];
  int64_t df = f1 - f0;
  if (df <= 0) return ((int32_t)lo) << 16;

  int64_t num = (freq_q24 - f0) << 16;
  int32_t frac = (int32_t)(num / df);
  if (frac < 0) frac = 0;
  if (frac > 0xFFFF) frac = 0xFFFF;
  return (((int32_t)lo) << 16) + frac;
}

// Helper: convert float Hz to Q24 fixed-point (Hz * 2^24)
static inline int64_t float_to_q24(float f) {
  return (int64_t)lrintf(f * (float)(1 << 24));
}

// midi/base + offset → table index using signed math (no uint8 wrap-to-top).
// High notes still fold down by octaves to stay within highestNote, then clamp.
static inline uint8_t midi_offset_to_table_index(int midi_or_base, int offset, size_t table_len) {
  int n = midi_or_base - 36 + offset;
  if (n < 0) n = 0;
  while (n > (int)highestNote) n -= 12;
  if (table_len == 0) return 0;
  if (n >= (int)table_len) n = (int)table_len - 1;
  return (uint8_t)n;
}

// Resolve porta start note (Q16). First edge snaps; later edges use cur note (incl. index 0).
static inline int32_t porta_resolve_start_note_q16(uint8_t osc, int32_t target_q16) {
  if (porta_note_valid[osc]) {
    return porta_note_cur_q16[osc];
  }
  if (portamento_cur_freq_q24[osc] > 0) {
    porta_note_valid[osc] = true;
    return freqQ24_to_noteQ16(portamento_cur_freq_q24[osc]);
  }
  porta_note_valid[osc] = true;
  return target_q16;
}

// Common endpoint latch for note-space porta setup.
static inline void porta_latch_endpoints_q16(uint8_t osc, int32_t start_q16, int32_t target_q16) {
  porta_note_start_q16[osc] = start_q16;
  porta_note_stop_q16[osc] = target_q16;
  porta_note_cur_q16[osc] = start_q16;
  porta_note_valid[osc] = true;
  int64_t freq_q24 = noteQ16_to_freqQ24(start_q16);
  portamento_start_q24[osc] = freq_q24;
  portamento_stop_q24[osc] = noteQ16_to_freqQ24(target_q16);
  portamento_cur_freq_q24[osc] = freq_q24;
}

// TIME: fixed duration T_fixed µs for any interval; linear in semitones.
static inline void porta_setup_time_q16(uint8_t osc, int32_t start_q16, int32_t target_q16,
                                       int32_t T_fixed) {
  if (T_fixed < 1) T_fixed = 1;
  porta_latch_endpoints_q16(osc, start_q16, target_q16);

  int32_t dNote_q16 = target_q16 - start_q16;
  int64_t halfT = (int64_t)T_fixed >> 1;
  int64_t num = (dNote_q16 >= 0) ? ((int64_t)dNote_q16 + halfT) : ((int64_t)dNote_q16 - halfT);
  porta_note_step_q16[osc] = (int32_t)(num / (int64_t)T_fixed);
  if (dNote_q16 != 0 && porta_note_step_q16[osc] == 0) {
    porta_note_step_q16[osc] = (dNote_q16 > 0) ? 1 : -1;
  }
}

// SLEW: constant rate = 12 semitones / T_slew (one octave takes the slew-time knob).
static inline void porta_setup_slew_q16(uint8_t osc, int32_t start_q16, int32_t target_q16,
                                       int32_t T_slew) {
  if (T_slew < 1) T_slew = 1;
  porta_latch_endpoints_q16(osc, start_q16, target_q16);

  int32_t dNote_q16 = target_q16 - start_q16;
  if (dNote_q16 == 0) {
    porta_note_step_q16[osc] = 0;
  } else {
    int32_t rate = (int32_t)(((int64_t)12 << 16) / (int64_t)T_slew);
    if (rate == 0) rate = 1;
    porta_note_step_q16[osc] = (dNote_q16 > 0) ? rate : -rate;
  }
}

static inline void porta_setup_glide_q16(uint8_t osc, int32_t start_q16, int32_t target_q16,
                                        uint8_t mode) {
  if (mode == PORTA_MODE_TIME) {
    int32_t T = (portamento_time_fixed == 0) ? 1 : (int32_t)portamento_time_fixed;
    porta_setup_time_q16(osc, start_q16, target_q16, T);
  } else {
    int32_t T = (portamento_time_slew == 0) ? 1 : (int32_t)portamento_time_slew;
    porta_setup_slew_q16(osc, start_q16, target_q16, T);
  }
}

#ifdef USE_FLOAT_VOICE_TASK
// Helper: convert a semitone index (float) to Hz using sNotePitches[] with linear interpolation.
static inline float noteIndex_to_freqFloat(float noteIndex) {
  const size_t LEN = sizeof(sNotePitches) / sizeof(sNotePitches[0]);
  if (LEN == 0) return 0.0f;
  if (noteIndex <= 0.0f) return sNotePitches[0];
  if (noteIndex >= (float)(LEN - 1)) return sNotePitches[LEN - 1];

  int n0 = (int)floorf(noteIndex);
  int n1 = n0 + 1;
  float t = noteIndex - (float)n0;
  float f0 = sNotePitches[n0];
  float f1 = sNotePitches[n1];
  return f0 + (f1 - f0) * t;
}

// Inverse of noteIndex_to_freqFloat: Hz → semitone index via binary search + linear frac.
static inline float freqFloat_to_noteIndex(float hz) {
  const size_t LEN = sizeof(sNotePitches) / sizeof(sNotePitches[0]);
  if (LEN == 0) return 0.0f;
  if (LEN == 1) return 0.0f;
  if (hz <= sNotePitches[0]) return 0.0f;
  if (hz >= sNotePitches[LEN - 1]) return (float)(LEN - 1);

  size_t lo = 0;
  size_t hi = LEN - 1;
  while (hi - lo > 1) {
    size_t mid = lo + ((hi - lo) >> 1);
    if (sNotePitches[mid] <= hz) {
      lo = mid;
    } else {
      hi = mid;
    }
  }

  float f0 = sNotePitches[lo];
  float f1 = sNotePitches[hi];
  float df = f1 - f0;
  if (df <= 0.0f) return (float)lo;
  return (float)lo + (hz - f0) / df;
}

static inline float porta_resolve_start_note_f(uint8_t osc, float target) {
  if (porta_note_valid[osc]) {
    return porta_note_cur_f[osc];
  }
  if (porta_freq_cur_f[osc] > 0.0f) {
    porta_note_valid[osc] = true;
    return freqFloat_to_noteIndex(porta_freq_cur_f[osc]);
  }
  porta_note_valid[osc] = true;
  return target;
}

static inline void porta_latch_endpoints_f(uint8_t osc, float startNote, float targetNote) {
  porta_note_start_f[osc] = startNote;
  porta_note_stop_f[osc] = targetNote;
  porta_note_cur_f[osc] = startNote;
  porta_note_valid[osc] = true;
  float startHz = noteIndex_to_freqFloat(startNote);
  float stopHz = noteIndex_to_freqFloat(targetNote);
  porta_freq_start_f[osc] = startHz;
  porta_freq_stop_f[osc] = stopHz;
  porta_freq_cur_f[osc] = startHz;
}

// TIME: fixed duration T_fixed µs for any interval; linear in semitones.
static inline void porta_setup_time_f(uint8_t osc, float startNote, float targetNote, float T_fixed) {
  if (T_fixed < 1.0f) T_fixed = 1.0f;
  porta_latch_endpoints_f(osc, startNote, targetNote);

  float dNote = targetNote - startNote;
  const float SCALE = 65536.0f;
  float halfT = 0.5f * T_fixed;
  float d_q16 = dNote * SCALE;
  float num = (d_q16 >= 0.0f) ? (d_q16 + halfT) : (d_q16 - halfT);
  float stepNote = (num / T_fixed) / SCALE;
  if (dNote != 0.0f && stepNote == 0.0f) {
    stepNote = (dNote > 0.0f) ? (1.0f / SCALE) : (-1.0f / SCALE);
  }
  porta_note_step_f[osc] = stepNote;
}

// SLEW: constant rate = 12 semitones / T_slew (one octave takes the slew-time knob).
static inline void porta_setup_slew_f(uint8_t osc, float startNote, float targetNote, float T_slew) {
  if (T_slew < 1.0f) T_slew = 1.0f;
  porta_latch_endpoints_f(osc, startNote, targetNote);

  float dNote = targetNote - startNote;
  if (dNote == 0.0f) {
    porta_note_step_f[osc] = 0.0f;
  } else {
    float rate = 12.0f / T_slew;
    if (rate == 0.0f) rate = 1.0f / 65536.0f;
    porta_note_step_f[osc] = (dNote > 0.0f) ? rate : -rate;
  }
}

static inline void porta_setup_glide_f(uint8_t osc, float startNote, float targetNote, uint8_t mode) {
  if (mode == PORTA_MODE_TIME) {
    float T = (portamento_time_fixed == 0) ? 1.0f : (float)portamento_time_fixed;
    porta_setup_time_f(osc, startNote, targetNote, T);
  } else {
    float T = (portamento_time_slew == 0) ? 1.0f : (float)portamento_time_slew;
    porta_setup_slew_f(osc, startNote, targetNote, T);
  }
}

// Q24 → float modifier/Hz scale (multiply avoids per-sample divide by 2^24).
static constexpr float Q24_TO_FLOAT = 1.0f / 16777216.0f;

static inline float q24_to_float(int32_t q) {
  return (float)q * Q24_TO_FLOAT;
}
#endif

#ifndef USE_FLOAT_VOICE_TASK
// Fixed-point realtime voice engine (portamento, modifiers, clkdiv, amp, PIO/PWM/PW).
// Selected by voice_task_main() when USE_FLOAT_VOICE_TASK is not defined.
void __not_in_flash_func(voice_task_fixed_point)() {
  static uint32_t last_portamento_time = 0;
  static uint8_t last_portamento_mode = PORTA_MODE_TIME;
  static uint8_t lastNote1[NUM_VOICES_TOTAL] = {};
  static uint8_t lastNote2[NUM_VOICES_TOTAL] = {};
  uint32_t portaTime = portamento_time;
  uint8_t portaMode = portamento_mode;
  bool portaTimeChanged = (portaTime != last_portamento_time);
  bool portaModeChanged = (portaMode != last_portamento_mode);

  int32_t calcPitchbend_q24;

  BENCH_BEGIN(vt_pitchbend);
  int32_t bend_normalized_q24 = ((int32_t)midi_pitch_bend << 11) - (1 << 24);
  calcPitchbend_q24 = (int32_t)(((int64_t)bend_normalized_q24 * pitchBendMultiplier_q24) >> 24);
  BENCH_END(vt_pitchbend);

  last_midi_pitch_bend = midi_pitch_bend;

  for (int k = 0; k < NUM_VOICES; k++) {
    if (note_on_flag[k] == 1) {
      note_on_flag_flag[k] = true;
      note_on_flag[k] = 0;
    }
  }

  for (int i = 0; i < NUM_VOICES; i++) {

#if DCO_DEBUG_REPORT
    float dbg_freq_base_Hz = 0.0f;
    float dbg_freq_after_mod_Hz = 0.0f;
#endif

    const size_t NOTE_TABLE_LEN = sizeof(sNotePitches_q24) / sizeof(sNotePitches_q24[0]);
    uint8_t note1, note2;
    const uint8_t vn = VOICE_NOTES[i];
    if (vn == 0) {
      note1 = note2 = 0;
    } else {
      note1 = midi_offset_to_table_index((int)vn, (int)octave_shift, NOTE_TABLE_LEN);
      note2 = midi_offset_to_table_index((int)note1, (int)OSC2_interval, NOTE_TABLE_LEN);
    }

    const bool pitchTargetChanged = note1 != lastNote1[i] || note2 != lastNote2[i];
    lastNote1[i] = note1;
    lastNote2[i] = note2;

    BENCH_BEGIN(vt_osc_detune);
    static constexpr int32_t DETUNE_SCALE_Q24 = (int32_t)(0.0002f * (float)(1 << 24) + 0.5f);
    int32_t detune_steps = ((int)256 - OSC2DetuneVal);
    int32_t detune_q24 = (1 << 24) + (detune_steps * DETUNE_SCALE_Q24);
    BENCH_END(vt_osc_detune);

    int64_t freq_q24_A;
    int64_t freq_q24_B;

    const uint8_t DCO_A = (uint8_t)(i * 2);
    const uint8_t DCO_B = (uint8_t)(i * 2 + 1);

    BENCH_BEGIN(vt_portamento);
    if (portaTime > 0) {
      uint32_t now_us = micros();
      portamentoTimer[i] = now_us - portamentoStartMicros[i];

      if (note_on_flag_flag[i]) {
        portamentoStartMicros[i] = now_us;
        portamentoTimer[i] = 0;

        int32_t targetNoteA_q16 = ((int32_t)note1) << 16;
        int32_t targetNoteB_q16 = ((int32_t)note2) << 16;
        porta_setup_glide_q16(DCO_A, porta_resolve_start_note_q16(DCO_A, targetNoteA_q16),
                              targetNoteA_q16, portaMode);
        porta_setup_glide_q16(DCO_B, porta_resolve_start_note_q16(DCO_B, targetNoteB_q16),
                              targetNoteB_q16, portaMode);
      }

      const bool portaDoRetime =
          (portaTimeChanged || portaModeChanged || pitchTargetChanged) && !note_on_flag_flag[i];

      int64_t curA;
      int64_t curB;

      if (portaDoRetime) {
        portamentoStartMicros[i] = now_us;
        portamentoTimer[i] = 0;

        int32_t targetNoteA_q16 = ((int32_t)note1) << 16;
        int32_t targetNoteB_q16 = ((int32_t)note2) << 16;
        int32_t curNoteA_q16 = freqQ24_to_noteQ16(portamento_cur_freq_q24[DCO_A]);
        int32_t curNoteB_q16 = freqQ24_to_noteQ16(portamento_cur_freq_q24[DCO_B]);
        porta_setup_glide_q16(DCO_A, curNoteA_q16, targetNoteA_q16, portaMode);
        porta_setup_glide_q16(DCO_B, curNoteB_q16, targetNoteB_q16, portaMode);
        curA = portamento_cur_freq_q24[DCO_A];
        curB = portamento_cur_freq_q24[DCO_B];
      } else if (porta_note_cur_q16[DCO_A] == porta_note_stop_q16[DCO_A] &&
                 porta_note_cur_q16[DCO_B] == porta_note_stop_q16[DCO_B]) {
        curA = portamento_stop_q24[DCO_A];
        curB = portamento_stop_q24[DCO_B];
      } else {
        int32_t elapsed = (int32_t)portamentoTimer[i];

        int32_t dNoteA_q16 = porta_note_stop_q16[DCO_A] - porta_note_start_q16[DCO_A];
        int32_t dNoteB_q16 = porta_note_stop_q16[DCO_B] - porta_note_start_q16[DCO_B];

        int64_t curNoteA_q16 = (int64_t)porta_note_start_q16[DCO_A] + (int64_t)porta_note_step_q16[DCO_A] * (int64_t)elapsed;
        int64_t curNoteB_q16 = (int64_t)porta_note_start_q16[DCO_B] + (int64_t)porta_note_step_q16[DCO_B] * (int64_t)elapsed;

        if ((dNoteA_q16 >= 0 && curNoteA_q16 >= (int64_t)porta_note_stop_q16[DCO_A]) ||
            (dNoteA_q16 < 0 && curNoteA_q16 <= (int64_t)porta_note_stop_q16[DCO_A])) {
          curNoteA_q16 = porta_note_stop_q16[DCO_A];
        }
        if ((dNoteB_q16 >= 0 && curNoteB_q16 >= (int64_t)porta_note_stop_q16[DCO_B]) ||
            (dNoteB_q16 < 0 && curNoteB_q16 <= (int64_t)porta_note_stop_q16[DCO_B])) {
          curNoteB_q16 = porta_note_stop_q16[DCO_B];
        }

        porta_note_cur_q16[DCO_A] = (int32_t)curNoteA_q16;
        porta_note_cur_q16[DCO_B] = (int32_t)curNoteB_q16;

        if (curNoteA_q16 == (int64_t)porta_note_stop_q16[DCO_A]) {
          curA = portamento_stop_q24[DCO_A];
        } else {
          curA = noteQ16_to_freqQ24(porta_note_cur_q16[DCO_A]);
        }
        if (curNoteB_q16 == (int64_t)porta_note_stop_q16[DCO_B]) {
          curB = portamento_stop_q24[DCO_B];
        } else {
          curB = noteQ16_to_freqQ24(porta_note_cur_q16[DCO_B]);
        }
      }

      portamento_cur_freq_q24[DCO_A] = curA;
      portamento_cur_freq_q24[DCO_B] = curB;
    } else {
      portamento_cur_freq_q24[DCO_A] = sNotePitches_q24[note1];
      portamento_start_q24[DCO_A] = portamento_cur_freq_q24[DCO_A];
      portamento_stop_q24[DCO_A] = portamento_cur_freq_q24[DCO_A];
      porta_note_cur_q16[DCO_A] = ((int32_t)note1) << 16;
      porta_note_stop_q16[DCO_A] = porta_note_cur_q16[DCO_A];
      porta_note_valid[DCO_A] = true;

      portamento_cur_freq_q24[DCO_B] = sNotePitches_q24[note2];
      portamento_start_q24[DCO_B] = portamento_cur_freq_q24[DCO_B];
      portamento_stop_q24[DCO_B] = portamento_cur_freq_q24[DCO_B];
      porta_note_cur_q16[DCO_B] = ((int32_t)note2) << 16;
      porta_note_stop_q16[DCO_B] = porta_note_cur_q16[DCO_B];
      porta_note_valid[DCO_B] = true;
    }

#if defined(BENCH_PATH_STATS)
    if (portaTime == 0) {
      BENCH_PATH_INC(porta_off);
    } else if (note_on_flag_flag[i]) {
      BENCH_PATH_INC(porta_note_on);
    } else if (portaTimeChanged || portaModeChanged || pitchTargetChanged) {
      BENCH_PATH_INC(porta_retime);
    } else if (portaMode == PORTA_MODE_TIME) {
      BENCH_PATH_INC(porta_steady_time);
    } else {
      BENCH_PATH_INC(porta_steady_slew);
    }
#endif
#if DCO_DEBUG_REPORT
    dbg_freq_base_Hz = (float)portamento_cur_freq_q24[DCO_A] / (float)(1 << 24);
#endif
    BENCH_END(vt_portamento);

    BENCH_BEGIN(vt_adsr_mod);
    int32_t ADSRModifier_q24 = 0;
    if (ADSR1toDETUNE1_scale_q24 != 0) {
      ADSRModifier_q24 = applyDepthQ24(env_dco_pitch_wave_q15(ADSR1Level_q15[i]),
                                       ADSR1toDETUNE1_scale_q24);
    }
    // ADSR3→pitch: 0=A, 1=B, 2=A+B (legacy), 3/4 ignored or map 4→A+B
    int32_t ADSRModifierOSC1_q24 = (ADSR3ToOscSelect == 0 || ADSR3ToOscSelect == 2 || ADSR3ToOscSelect == 4) ? ADSRModifier_q24 : 0;
    int32_t ADSRModifierOSC2_q24 = (ADSR3ToOscSelect == 1 || ADSR3ToOscSelect == 2 || ADSR3ToOscSelect == 4) ? ADSRModifier_q24 : 0;
    BENCH_END(vt_adsr_mod);

    BENCH_BEGIN(vt_unison_mod);
    static constexpr int32_t UNISON_SCALE_Q24 = (int32_t)(0.0001f * (float)(1 << 24) + 0.5f);
    const int32_t unisonBase = (int32_t)unisonDetune * UNISON_SCALE_Q24;
    int32_t voiceMag = (i >> 1) + 1;
    int32_t voiceSign = ((i & 0x01) == 0) ? 1 : -1;
    int32_t unisonMODIFIER_q24 = unisonBase * (voiceSign * voiceMag);
    BENCH_END(vt_unison_mod);

    BENCH_BEGIN(vt_drift_mod);
    const int32_t driftScale_q24 = drift_pitch_scale_q24;
    const int16_t driftA = LFO_DRIFT_LEVEL[DCO_A];
    const int16_t driftB = LFO_DRIFT_LEVEL[DCO_B];
    int32_t DETUNE_DRIFT_OSC1_q24 =
      (driftScale_q24 != 0) ? applyDepthQ24(driftA, driftScale_q24) : 0;
    int32_t DETUNE_DRIFT_OSC2_q24 =
      (driftScale_q24 != 0) ? applyDepthQ24(driftB, driftScale_q24) : 0;
    BENCH_END(vt_drift_mod);

    int32_t modifiersBase_q24;
    int32_t freqModifiers_q24;
    int32_t freq2Modifiers_q24;
    {
      const int32_t local_lfo1_osc1 = lfo1_pitch_mod_q24[LFO1_PITCH_OSC1];
      const int32_t local_lfo1_osc2 = lfo1_pitch_mod_q24[LFO1_PITCH_OSC2];
      const int32_t local_lfo2_osc2 = lfo2_pitch_mod_q24[LFO2_PITCH_OSC2];
      BENCH_BEGIN(vt_modifiers);
      modifiersBase_q24 =
        calcPitchbend_q24 + Q24_ONE_EPS + matrix_pitch_mod_q24 + unisonMODIFIER_q24;
      if (char_pitch_scale_q15) {
        modifiersBase_q24 += character_pitch_delta_q24();
      }
      freqModifiers_q24 = ADSRModifierOSC1_q24 + DETUNE_DRIFT_OSC1_q24 + modifiersBase_q24 + local_lfo1_osc1;
      freq2Modifiers_q24 = ADSRModifierOSC2_q24 + DETUNE_DRIFT_OSC2_q24 + modifiersBase_q24 + local_lfo1_osc2 + local_lfo2_osc2;
      BENCH_END(vt_modifiers);
    }

    BENCH_BEGIN(vt_freq_scale_x);
    int32_t xScaled1_Q16 = modifiers_q24_to_xQ16(freqModifiers_q24);
    int32_t xScaled2_Q16 = modifiers_q24_to_xQ16(freq2Modifiers_q24);
    BENCH_END(vt_freq_scale_x);

    BENCH_BEGIN(vt_ratio_interp);
    int32_t ratio1_Q16 = interpolate_live_ratio_q16(xScaled1_Q16, DCO_A);
    int32_t ratio2_Q16 = interpolate_live_ratio_q16(xScaled2_Q16, DCO_B);
    BENCH_END(vt_ratio_interp);

    BENCH_BEGIN(vt_freq_scale_post);
    freq_q24_A = (portamento_cur_freq_q24[DCO_A] * (int64_t)ratio1_Q16) >> 16;
    int32_t detune_Q16 = (int32_t)((((int64_t)detune_q24) + 128) >> 8);
    int32_t combined_Q16 = (int32_t)((((int64_t)ratio2_Q16 * (int64_t)detune_Q16) + (1LL << 15)) >> 16);
    freq_q24_B = (portamento_cur_freq_q24[DCO_B] * (int64_t)combined_Q16) >> 16;

#if DCO_DEBUG_REPORT
    dbg_freq_after_mod_Hz = (float)freq_q24_A / (float)(1 << 24);
#endif
    BENCH_END(vt_freq_scale_post);

    BENCH_BEGIN(vt_clk_div);

    PIO pioN_A = pio[VOICE_TO_PIO[DCO_A]];
    PIO pioN_B = pio[VOICE_TO_PIO[DCO_B]];
    uint8_t smAN = VOICE_TO_SM[DCO_A];
    uint8_t smBN = VOICE_TO_SM[DCO_B];

    uint32_t clk_div1, clk_div2;

    uint8_t arbitrary_measured_correction_value = 0;

    uint32_t total_cycles1, total_cycles2;
    const uint32_t sys_hz = sysClock_Hz;

    const uint32_t wA = osc_ramp_weight(DCO_A), kA = osc_period_overhead(DCO_A);
    const uint32_t wB = osc_ramp_weight(DCO_B), kB = osc_period_overhead(DCO_B);
    const uint32_t yA = osc_last_y[DCO_A];
    const uint32_t yB = osc_last_y[DCO_B];

    total_cycles1 = clkdiv_live_total_cycles(sys_hz, freq_q24_A);
    total_cycles2 = clkdiv_live_total_cycles(sys_hz, freq_q24_B);
    total_cycles1 += arbitrary_measured_correction_value;
    total_cycles2 += arbitrary_measured_correction_value;
    clk_div1 = pio_clk_div_for_y(total_cycles1, yA, wA, kA);
    clk_div2 = pio_clk_div_for_y(total_cycles2, yB, wB, kB);
    BENCH_END(vt_clk_div);

    uint32_t phaseHoldX = 0;
    PioPeriod retrig_p1{};
    PioPeriod retrig_p2{};
    if (note_on_flag_flag[i] && oscSync > 1 && phaseAlignOSC2 != 0) {
      BENCH_BEGIN(vt_phase_align);
      phaseHoldX = osc_phase_hold_x(total_cycles2, phaseAlignOSC2);
      BENCH_END(vt_phase_align);
    }
    if (note_on_flag_flag[i] && oscSync >= 1 &&
        note_retrig_mode != NOTE_RETRIG_SYNC_JMP) {
      BENCH_BEGIN(vt_retrig_split);
      retrig_p1 = pio_period_split(total_cycles1, wA, kA);
      retrig_p2 = pio_period_split(total_cycles2, wB, kB);
      BENCH_END(vt_retrig_split);
    }

    BENCH_BEGIN(vt_chan_level);
    uint16_t chanLevel, chanLevel2;
    amp_chan_levels_fixed(freq_q24_A, freq_q24_B, DCO_A, DCO_B,
                          &chanLevel, &chanLevel2);
    BENCH_END(vt_chan_level);

    BENCH_BEGIN(vt_pio_write);
    pio_sm_put(pioN_A, smAN, clk_div1);
    pio_sm_put(pioN_B, smBN, clk_div2);
    pio_sm_exec(pioN_A, smAN, pio_encode_pull(false, false));
    pio_sm_exec(pioN_B, smBN, pio_encode_pull(false, false));
    osc_last_clk_div[DCO_A] = clk_div1;
    osc_last_clk_div[DCO_B] = clk_div2;
    BENCH_END(vt_pio_write);

    if (note_on_flag_flag[i]) {
      BENCH_BEGIN(vt_note_retrig);
#if DCO_DEBUG_REPORT
      uint32_t actual_total_osr_val = clk_div1 * wA;
      uint32_t actual_total_period = osc_last_y[DCO_A] + actual_total_osr_val + kA;
      float expected_freq = (double)sysClock_Hz / (double)actual_total_period;
      PioPeriod p1dbg = pio_period_split(total_cycles1, wA, kA);
      Serial.println("----------------[ DCO DEBUG REPORT ]----------------");
      Serial.printf("Target Freq In:   %.2f Hz\n", (float)freq_q24_A / (float)(1 << 24));
      Serial.printf("Total Cycles Calc:  %lu (Target for the whole period)\n", total_cycles1);
      Serial.printf("Reset pulse (Y):    %lu cycles (incl. period remainder)\n", p1dbg.y);
      Serial.printf("Period Overhead:    %lu cycles (program constant)\n", kA);
      Serial.printf("Total OSR Delay:    %lu cycles (Remaining for loops)\n", p1dbg.clk_div * wA);
      Serial.printf("clk_div (Exact):    %lu (Value sent to PIO)\n", p1dbg.clk_div);
      Serial.println("---");
      Serial.printf("Actual Period Gen:  %lu cycles (Y + (clk_div*%u) + overhead)\n",
                    actual_total_period, (unsigned)wA);
      Serial.printf("==> Expected Freq Out: %.2f Hz\n", expected_freq);
      Serial.println("---");
      Serial.println("OSC1 Frequency Stages:");
      Serial.printf("  Base after portamento:     %.4f Hz\n", dbg_freq_base_Hz);
      Serial.printf("  After modifiers (Q24):     %.4f Hz\n", dbg_freq_after_mod_Hz);
      Serial.printf("  Quantized by PIO (clkdiv): %.4f Hz\n", expected_freq);
      Serial.println("----------------------------------------------------\n");
#endif

      if (oscSync >= 1) {
        BENCH_BEGIN(vt_retrig_sm_apply);
        if (note_retrig_mode != NOTE_RETRIG_SYNC_JMP) {
          uint32_t maskAB = (1u << smAN) | (1u << smBN);
          pio_set_sm_mask_enabled(pioN_A, maskAB, false);

          osc_load_periods_stopped_noclear(DCO_A, retrig_p1.y, retrig_p1.clk_div,
                                           DCO_B, retrig_p2.y, retrig_p2.clk_div);

          pio_sm_exec(pioN_A, smAN, pio_encode_jmp(osc_restart_target(DCO_A)));

          if (phaseHoldX != 0) {
            osc_phase_align_hold_stopped(DCO_B, phaseHoldX);
          } else {
            pio_sm_exec(pioN_B, smBN, pio_encode_jmp(osc_restart_target(DCO_B)));
          }

          pio_enable_sm_mask_in_sync(pioN_A, maskAB);
        } else {
          pio_sm_exec(pioN_A, smAN, pio_encode_jmp(osc_restart_target(DCO_A)));
          pio_sm_exec(pioN_B, smBN, pio_encode_jmp(osc_restart_target(DCO_B)));
        }
        BENCH_END(vt_retrig_sm_apply);
      }

      BENCH_BEGIN(vt_retrig_pwm);
      voice_write_range_pair(DCO_A, DCO_B, chanLevel, chanLevel2);
      BENCH_END(vt_retrig_pwm);
      BENCH_END(vt_note_retrig);
    }

    if (timer99microsFlag2) {
      BENCH_BEGIN(vt_range_pwm);
      voice_write_range_pair(DCO_A, DCO_B, chanLevel, chanLevel2);
      BENCH_END(vt_range_pwm);

      const bool pulseOn = waveEnable[0][1] || waveEnable[1][1];
      if (pulseOn) {
        const int16_t local_LFO2Level = LFO2Level;
        const int16_t local_LFO2toPW = LFO2toPW;
        BENCH_FBEGIN(vt_pwm_calc);
        int32_t adsr1_delta =
          ((int32_t)ADSR1Level_q15[i] * ADSR1toPWM_scale) >> 15;
        int32_t lfo2_delta =
          ((int32_t)local_LFO2Level * (int32_t)local_LFO2toPW) >> 15;
        int32_t pw_calc = (int32_t)DIV_COUNTER_PW - 1 - lfo2_delta - PW[0] + adsr1_delta
                          + character_pw_delta();

        if (pw_calc < 0) pw_calc = 0;
        if (pw_calc > (int32_t)DIV_COUNTER_PW - 1) pw_calc = (int32_t)DIV_COUNTER_PW - 1;
        PW_PWM[i] = (uint16_t)pw_calc;
        BENCH_FEND(vt_pwm_calc);

        BENCH_BEGIN(vt_pw_update);
        voice_write_pw(i, get_PW_level_interpolated(PW_PWM[i], i));
        BENCH_END(vt_pw_update);
      } else {
        BENCH_BEGIN(vt_pw_update);
        voice_write_pw(i, 0);
        BENCH_END(vt_pw_update);
      }
    }
  }

  for (int k = 0; k < NUM_VOICES; k++) {
    note_on_flag_flag[k] = false;
  }

  last_portamento_time = portaTime;
  last_portamento_mode = portaMode;
}

#endif  // !USE_FLOAT_VOICE_TASK

// Dispatch entry point: select float vs fixed-point implementation at compile time.
inline void voice_task_main() {
#ifdef USE_FLOAT_VOICE_TASK
  voice_task_float();
#else
  voice_task_fixed_point();
#endif
}

#ifdef USE_FLOAT_VOICE_TASK
// Float realtime voice engine (same stages as voice_task_fixed_point, in Hz). Board default on RP2350.
void __not_in_flash_func(voice_task_float)() {
    static uint32_t last_portamento_time = 0;
    static uint8_t  last_portamento_mode = PORTA_MODE_SLEW;
    static uint8_t lastNote1[NUM_VOICES_TOTAL] = {};
    static uint8_t lastNote2[NUM_VOICES_TOTAL] = {};
    uint32_t portaTime = portamento_time;
    uint8_t  portaMode = portamento_mode;
    bool portaTimeChanged = (portaTime != last_portamento_time);
    bool portaModeChanged = (portaMode != last_portamento_mode);

    BENCH_BEGIN(vt_pitchbend);
    float pitchBendMultiplier = q24_to_float(pitchBendMultiplier_q24);
    float calcPitchbend;

    if (midi_pitch_bend == 8192) {
      calcPitchbend = 0.0f;
    } else if (midi_pitch_bend < 8192) {
      calcPitchbend = (((float)midi_pitch_bend / 8190.99f) - 1.0f) * pitchBendMultiplier;
    } else {
      calcPitchbend = (((float)midi_pitch_bend / 8192.99f) - 1.0f) * pitchBendMultiplier;
    }
    BENCH_END(vt_pitchbend);

    last_midi_pitch_bend = midi_pitch_bend;

    for (int k = 0; k < NUM_VOICES; k++) {
      if (note_on_flag[k] == 1) {
        note_on_flag_flag[k] = true;
        note_on_flag[k] = 0;
      }
    }

    for (int i = 0; i < NUM_VOICES; ++i) {

  #if DCO_DEBUG_REPORT
      float dbg_freq_base_Hz      = 0.0f;
      float dbg_freq_after_mod_Hz = 0.0f;
  #endif

      const size_t NOTE_TABLE_LEN = sizeof(sNotePitches) / sizeof(sNotePitches[0]);
      uint8_t note1, note2;
      const uint8_t vn = VOICE_NOTES[i];
      if (vn == 0) {
        note1 = note2 = 0;
      } else {
        note1 = midi_offset_to_table_index((int)vn, (int)octave_shift, NOTE_TABLE_LEN);
        note2 = midi_offset_to_table_index((int)note1, (int)OSC2_interval, NOTE_TABLE_LEN);
      }

      const bool pitchTargetChanged = note1 != lastNote1[i] || note2 != lastNote2[i];
      lastNote1[i] = note1;
      lastNote2[i] = note2;

      BENCH_BEGIN(vt_osc_detune);
      float detuneSteps = (float)((int)256 - OSC2DetuneVal);
      float osc2DetuneRatio = 1.0f + 0.0002f * detuneSteps;
      BENCH_END(vt_osc_detune);

      float noteFreq1 = sNotePitches[note1];
      float noteFreq2 = sNotePitches[note2];

      float freqA, freqB;

      const uint8_t DCO_A = (uint8_t)(i * 2);
      const uint8_t DCO_B = (uint8_t)(i * 2 + 1);

      BENCH_BEGIN(vt_portamento);

      if (portaTime > 0) {
        uint32_t now_us = micros();
        portamentoTimer[i] = now_us - portamentoStartMicros[i];

        if (note_on_flag_flag[i]) {
          portamentoStartMicros[i] = now_us;
          portamentoTimer[i]       = 0;

          float targetNoteA = (float)note1;
          float targetNoteB = (float)note2;
          porta_setup_glide_f(DCO_A, porta_resolve_start_note_f(DCO_A, targetNoteA),
                              targetNoteA, portaMode);
          porta_setup_glide_f(DCO_B, porta_resolve_start_note_f(DCO_B, targetNoteB),
                              targetNoteB, portaMode);
        }

        const bool portaDoRetime =
            (portaTimeChanged || portaModeChanged || pitchTargetChanged) && !note_on_flag_flag[i];

        float curA, curB;
        if (portaDoRetime) {
          portamentoStartMicros[i] = now_us;
          portamentoTimer[i]       = 0;

          float curNoteA = freqFloat_to_noteIndex(porta_freq_cur_f[DCO_A]);
          float curNoteB = freqFloat_to_noteIndex(porta_freq_cur_f[DCO_B]);
          porta_setup_glide_f(DCO_A, curNoteA, (float)note1, portaMode);
          porta_setup_glide_f(DCO_B, curNoteB, (float)note2, portaMode);
          curA = porta_freq_cur_f[DCO_A];
          curB = porta_freq_cur_f[DCO_B];
        } else if (porta_note_cur_f[DCO_A] == porta_note_stop_f[DCO_A] &&
                   porta_note_cur_f[DCO_B] == porta_note_stop_f[DCO_B]) {
          curA = porta_freq_stop_f[DCO_A];
          curB = porta_freq_stop_f[DCO_B];
        } else {
          int32_t elapsed = (int32_t)portamentoTimer[i];

          float startNoteA = porta_note_start_f[DCO_A];
          float startNoteB = porta_note_start_f[DCO_B];
          float stopNoteA  = porta_note_stop_f [DCO_A];
          float stopNoteB  = porta_note_stop_f [DCO_B];

          float dNoteA = stopNoteA - startNoteA;
          float dNoteB = stopNoteB - startNoteB;

          float curNoteA = startNoteA + porta_note_step_f[DCO_A] * (float)elapsed;
          float curNoteB = startNoteB + porta_note_step_f[DCO_B] * (float)elapsed;

          if ((dNoteA >= 0.0f && curNoteA >= stopNoteA) ||
              (dNoteA <  0.0f && curNoteA <= stopNoteA)) {
            curNoteA = stopNoteA;
          }
          if ((dNoteB >= 0.0f && curNoteB >= stopNoteB) ||
              (dNoteB <  0.0f && curNoteB <= stopNoteB)) {
            curNoteB = stopNoteB;
          }

          porta_note_cur_f[DCO_A] = curNoteA;
          porta_note_cur_f[DCO_B] = curNoteB;

          curA = (curNoteA == stopNoteA) ? porta_freq_stop_f[DCO_A]
                                         : noteIndex_to_freqFloat(curNoteA);
          curB = (curNoteB == stopNoteB) ? porta_freq_stop_f[DCO_B]
                                         : noteIndex_to_freqFloat(curNoteB);

          porta_freq_cur_f[DCO_A] = curA;
          porta_freq_cur_f[DCO_B] = curB;
        }

        freqA = curA;
        freqB = curB;

      } else {
        freqA = noteFreq1;
        freqB = noteFreq2;

        porta_freq_cur_f[DCO_A] = freqA;
        porta_freq_cur_f[DCO_B] = freqB;
        porta_freq_stop_f[DCO_A] = freqA;
        porta_freq_stop_f[DCO_B] = freqB;
        porta_note_cur_f[DCO_A] = (float)note1;
        porta_note_cur_f[DCO_B] = (float)note2;
        porta_note_stop_f[DCO_A] = (float)note1;
        porta_note_stop_f[DCO_B] = (float)note2;
        porta_note_valid[DCO_A] = true;
        porta_note_valid[DCO_B] = true;
      }

#if defined(BENCH_PATH_STATS)
      if (portaTime == 0) {
        BENCH_PATH_INC(porta_off);
      } else if (note_on_flag_flag[i]) {
        BENCH_PATH_INC(porta_note_on);
      } else if (portaTimeChanged || portaModeChanged || pitchTargetChanged) {
        BENCH_PATH_INC(porta_retime);
      } else if (portaMode == PORTA_MODE_TIME) {
        BENCH_PATH_INC(porta_steady_time);
      } else {
        BENCH_PATH_INC(porta_steady_slew);
      }
#endif

  #if DCO_DEBUG_REPORT
      dbg_freq_base_Hz = freqA;
  #endif

      BENCH_END(vt_portamento);

      BENCH_BEGIN(vt_adsr_mod);
      float ADSRModifier = 0.0f;
      if (ADSR1toDETUNE1_scale_q24 != 0) {
        ADSRModifier = q24_to_float(applyDepthQ24(
            env_dco_pitch_wave_q15(ADSR1Level_q15[i]), ADSR1toDETUNE1_scale_q24));
      }
      float ADSRModifierOSC1 = (ADSR3ToOscSelect == 0 || ADSR3ToOscSelect == 2 || ADSR3ToOscSelect == 4) ? ADSRModifier : 0.0f;
      float ADSRModifierOSC2 = (ADSR3ToOscSelect == 1 || ADSR3ToOscSelect == 2 || ADSR3ToOscSelect == 4) ? ADSRModifier : 0.0f;
      BENCH_END(vt_adsr_mod);

      BENCH_BEGIN(vt_unison_mod);
      static constexpr float UNISON_SCALE = 0.0001f;
      const float unisonBase = (float)unisonDetune * UNISON_SCALE;
      float voiceMag = (float)((i >> 1) + 1);
      float voiceSign = ((i & 0x01) == 0) ? 1.0f : -1.0f;
      float unisonMODIFIER = unisonBase * (voiceSign * voiceMag);
      BENCH_END(vt_unison_mod);

      BENCH_BEGIN(vt_drift_mod);
      const int32_t driftScale_q24 = drift_pitch_scale_q24;
      const int16_t driftA = LFO_DRIFT_LEVEL[DCO_A];
      const int16_t driftB = LFO_DRIFT_LEVEL[DCO_B];
      float DETUNE_DRIFT_OSC1 =
        (driftScale_q24 != 0) ? q24_to_float(applyDepthQ24(driftA, driftScale_q24)) : 0.0f;
      float DETUNE_DRIFT_OSC2 =
        (driftScale_q24 != 0) ? q24_to_float(applyDepthQ24(driftB, driftScale_q24)) : 0.0f;
      BENCH_END(vt_drift_mod);

      float freqModifiers1;
      float freqModifiers2;
      {
        const int32_t local_lfo1_osc1 = lfo1_pitch_mod_q24[LFO1_PITCH_OSC1];
        const int32_t local_lfo1_osc2 = lfo1_pitch_mod_q24[LFO1_PITCH_OSC2];
        const int32_t local_lfo2_osc2 = lfo2_pitch_mod_q24[LFO2_PITCH_OSC2];
        BENCH_BEGIN(vt_modifiers);
        float lfo1_osc1        = q24_to_float(local_lfo1_osc1);
        float lfo1_osc2        = q24_to_float(local_lfo1_osc2);
        float lfo2_osc2        = q24_to_float(local_lfo2_osc2);
        float eps              = q24_to_float(Q24_ONE_EPS);
        float pitchBendF   = calcPitchbend;

        float modifiersBase = pitchBendF + eps + q24_to_float(matrix_pitch_mod_q24) + unisonMODIFIER;
        if (char_pitch_scale_q15) {
          modifiersBase += q24_to_float(character_pitch_delta_q24());
        }
        freqModifiers1 = ADSRModifierOSC1 + DETUNE_DRIFT_OSC1 + modifiersBase + lfo1_osc1;
        freqModifiers2 = ADSRModifierOSC2 + DETUNE_DRIFT_OSC2 + modifiersBase + lfo1_osc2 + lfo2_osc2;
        BENCH_END(vt_modifiers);
      }

      BENCH_BEGIN(vt_freq_scale_x);
      BENCH_END(vt_freq_scale_x);

      BENCH_BEGIN(vt_ratio_interp);
      float ratio1 = interpolate_live_ratio_f(freqModifiers1, DCO_A);
      float ratio2 = interpolate_live_ratio_f(freqModifiers2, DCO_B);
      BENCH_END(vt_ratio_interp);

      BENCH_BEGIN(vt_freq_scale_post);
      float freqA_Hz = freqA * ratio1;
      float freqB_Hz = freqB * (ratio2 * osc2DetuneRatio);

  #if DCO_DEBUG_REPORT
      dbg_freq_after_mod_Hz = freqA_Hz;
  #endif

      BENCH_END(vt_freq_scale_post);

      BENCH_BEGIN(vt_clk_div);

      float correction = 0.0f;
      const uint32_t sys_hz = sysClock_Hz;
      uint32_t total_cycles1 = clkdiv_live_hz_total_cycles(sys_hz, freqA_Hz)
                               + (uint32_t)correction;
      uint32_t total_cycles2 = clkdiv_live_hz_total_cycles(sys_hz, freqB_Hz)
                               + (uint32_t)correction;

      const uint32_t wA = osc_ramp_weight(DCO_A), kA = osc_period_overhead(DCO_A);
      const uint32_t wB = osc_ramp_weight(DCO_B), kB = osc_period_overhead(DCO_B);

      uint32_t clk_div1 = pio_clk_div_for_y(total_cycles1, osc_last_y[DCO_A], wA, kA);
      uint32_t clk_div2 = pio_clk_div_for_y(total_cycles2, osc_last_y[DCO_B], wB, kB);
      BENCH_END(vt_clk_div);

      uint32_t phaseHoldX = 0;
      PioPeriod retrig_p1{};
      PioPeriod retrig_p2{};
      if (note_on_flag_flag[i] && oscSync > 1 && phaseAlignOSC2 != 0) {
        BENCH_BEGIN(vt_phase_align);
        phaseHoldX = osc_phase_hold_x(total_cycles2, phaseAlignOSC2);
        BENCH_END(vt_phase_align);
      }
      if (note_on_flag_flag[i] && oscSync >= 1 &&
          note_retrig_mode != NOTE_RETRIG_SYNC_JMP) {
        BENCH_BEGIN(vt_retrig_split);
        retrig_p1 = pio_period_split(total_cycles1, wA, kA);
        retrig_p2 = pio_period_split(total_cycles2, wB, kB);
        BENCH_END(vt_retrig_split);
      }

      BENCH_BEGIN(vt_chan_level);
      uint16_t chanLevel, chanLevel2;
      switch (syncMode) {
        case 1: {
          float maxFreq = (freqA_Hz > freqB_Hz) ? freqA_Hz : freqB_Hz;
          chanLevel  = get_chan_level_for_engine(maxFreq, DCO_A);
          chanLevel2 = get_chan_level_for_engine(freqB_Hz, DCO_B);
          break;
        }
        case 2: {
          float maxFreq = (freqA_Hz > freqB_Hz) ? freqA_Hz : freqB_Hz;
          chanLevel  = get_chan_level_for_engine(freqA_Hz, DCO_A);
          chanLevel2 = get_chan_level_for_engine(maxFreq, DCO_B);
          break;
        }
        default:
          chanLevel  = get_chan_level_for_engine(freqA_Hz, DCO_A);
          chanLevel2 = get_chan_level_for_engine(freqB_Hz, DCO_B);
          break;
      }
      BENCH_END(vt_chan_level);

      PIO pioN_A = pio[VOICE_TO_PIO[DCO_A]];
      PIO pioN_B = pio[VOICE_TO_PIO[DCO_B]];
      uint8_t sm1N = VOICE_TO_SM[DCO_A];
      uint8_t sm2N = VOICE_TO_SM[DCO_B];

      BENCH_BEGIN(vt_pio_write);
      pio_sm_put(pioN_A, sm1N, clk_div1);
      pio_sm_put(pioN_B, sm2N, clk_div2);
      pio_sm_exec(pioN_A, sm1N, pio_encode_pull(false, false));
      pio_sm_exec(pioN_B, sm2N, pio_encode_pull(false, false));
      osc_last_clk_div[DCO_A] = clk_div1;
      osc_last_clk_div[DCO_B] = clk_div2;
      BENCH_END(vt_pio_write);

      if (note_on_flag_flag[i]) {
        BENCH_BEGIN(vt_note_retrig);
        if (oscSync >= 1) {
          BENCH_BEGIN(vt_retrig_sm_apply);
          if (note_retrig_mode != NOTE_RETRIG_SYNC_JMP) {
            uint32_t maskAB = (1u << sm1N) | (1u << sm2N);
            pio_set_sm_mask_enabled(pioN_A, maskAB, false);

            osc_load_periods_stopped_noclear(DCO_A, retrig_p1.y, retrig_p1.clk_div,
                                             DCO_B, retrig_p2.y, retrig_p2.clk_div);

            pio_sm_exec(pioN_A, sm1N, pio_encode_jmp(osc_restart_target(DCO_A)));

            if (phaseHoldX != 0) {
              osc_phase_align_hold_stopped(DCO_B, phaseHoldX);
            } else {
              pio_sm_exec(pioN_B, sm2N, pio_encode_jmp(osc_restart_target(DCO_B)));
            }

            pio_enable_sm_mask_in_sync(pioN_A, maskAB);
          } else {
            pio_sm_exec(pioN_A, sm1N, pio_encode_jmp(osc_restart_target(DCO_A)));
            pio_sm_exec(pioN_B, sm2N, pio_encode_jmp(osc_restart_target(DCO_B)));
          }
          BENCH_END(vt_retrig_sm_apply);
        }

        BENCH_BEGIN(vt_retrig_pwm);
        voice_write_range_pair(DCO_A, DCO_B, chanLevel, chanLevel2);
        BENCH_END(vt_retrig_pwm);
        BENCH_END(vt_note_retrig);
      }

      if (timer99microsFlag2) {
        BENCH_BEGIN(vt_range_pwm);
        voice_write_range_pair(DCO_A, DCO_B, chanLevel, chanLevel2);
        BENCH_END(vt_range_pwm);

        const bool pulseOn = waveEnable[0][1] || waveEnable[1][1];
        if (pulseOn) {
          const int16_t local_LFO2Level = LFO2Level;
          const int16_t local_LFO2toPW = LFO2toPW;
          BENCH_FBEGIN(vt_pwm_calc);
          float adsr1_delta =
            ((float)ADSR1Level_q15[i] * (float)ADSR1toPWM_scale) * (1.0f / 32768.0f);
          float lfo2_delta =
            ((float)local_LFO2Level * (float)local_LFO2toPW) * (1.0f / 32767.0f);
          float pw_calc =
              (float)DIV_COUNTER_PW - 1.0f
            - (float)PW[0]
            - lfo2_delta
            + adsr1_delta
            + (float)character_pw_delta();

          if (pw_calc < 0.0f) pw_calc = 0.0f;
          if (pw_calc > (float)(DIV_COUNTER_PW - 1)) pw_calc = (float)(DIV_COUNTER_PW - 1);

          PW_PWM[i] = (uint16_t)pw_calc;
          BENCH_FEND(vt_pwm_calc);

          BENCH_BEGIN(vt_pw_update);
          voice_write_pw(i, get_PW_level_interpolated(PW_PWM[i], i));
          BENCH_END(vt_pw_update);
        } else {
          BENCH_BEGIN(vt_pw_update);
          voice_write_pw(i, 0);
          BENCH_END(vt_pw_update);
        }
      }
    }

    for (int k = 0; k < NUM_VOICES; k++) {
      note_on_flag_flag[k] = false;
    }

  last_portamento_time = portaTime;
  last_portamento_mode = portaMode;
}

#endif  // USE_FLOAT_VOICE_TASK

// --- Voice allocation --------------------------------------------------------
// Thin adapters over the shared allocator (DCO-SHARED-LIBRARIES/voice_alloc.h,
// instance in voice_alloc_state.h). Every policy in VoiceAllocMode lives there;
// these keep the sketch's gate flag, pitch table and ADSR edge flags in step
// with the allocator's bookkeeping so no caller has to update both.

// Choose a voice for an incoming note. Returns VOICE_ALLOC_NONE when the mode
// refuses to steal.
uint8_t voice_alloc() {
#ifdef ENABLE_MB_MOD_STREAM
  // No level source on this build, so the allocator ranks release tails by
  // elapsed time. ADSR_VCA_release is written from the CC handler, the preset
  // load and the Mainboard block, so refresh it here rather than at each.
  voiceAlloc.setReleaseMs(ADSR_VCA_release);
#endif
  return voiceAlloc.alloc();
}

// Mark a voice as sounding a new note. Shared by every note_on path so the
// allocation bookkeeping never drifts from the gate flags.
void voice_mark_on(uint8_t voice, uint8_t note, uint8_t velocity) {
  VOICES[voice] = 1;
  VOICE_NOTES[voice] = note;
  midi_velocity[voice] = velocity;
  note_on_flag[voice] = 1;
  noteStart[voice] = 1;
  noteEnd[voice] = 0;
  voiceAlloc.markOn(voice, note);
}

// Gate a voice off and start tracking its release tail.
void voice_mark_off(uint8_t voice) {
  VOICES[voice] = 0;
  noteEnd[voice] = 1;
  noteStart[voice] = 0;
  voiceAlloc.markOff(voice);
}

// Map voiceMode → NUM_VOICES / STACK_VOICES. Called from init_voices and apply_param_voice_mode.
//   0 mono:  one MIDI voice → osc pair 0/1
//   1 poly:  NUM_VOICES_TOTAL independent 2-osc voices
//   2 stack: all voices, same note
inline void setVoiceMode() {
  // Resync allocation state to the gates: a slot that NUM_VOICES dropped mid-note
  // would otherwise come back HELD when the count grows again.
  voiceAlloc.resyncFromGates(VOICES);

  switch (voiceMode) {
    case 0:
      NUM_VOICES = 1;
      STACK_VOICES = 1;
      // Drop any stale held notes when entering mono.
      mono_note_stack_clear();
      break;
    case 1:
      NUM_VOICES = NUM_VOICES_TOTAL;
      STACK_VOICES = 1;
      break;
    case 2:
      NUM_VOICES = NUM_VOICES_TOTAL;
      STACK_VOICES = NUM_VOICES_TOTAL;
      break;
  }

  voiceAlloc.setVoiceCount(NUM_VOICES);
}

// Rebuild the PIO sync topology and retrigger voices.
// Called from apply_param_sync_mode (Serial2).
void setSyncMode() {
  // assign_sm_mapping() keeps the slave below its master in SM index; start_voice_sms()
  // re-derives every SM's program, set pin and sideset pin from syncMode and
  // softSyncChunks, then starts them all on the same cycle.
  //
  // The old implementation poked sideset pins in place and called pio_sm_restart(),
  // which cleared the shift counters but left PC, X and Y — it could strand an SM
  // mid-loop with a stale X for one glitched period. The note_on_flag retrigger below
  // already re-pushes everything, so the restart was never needed.
  assign_sm_mapping();
  start_voice_sms();

  for (int i = 0; i < NUM_VOICES_TOTAL; i++) {
    note_on_flag[i] = 1;
  }
}

// One osc: shipping FIXED = Q24→Q8 lookup. With USE_FLOAT_AMP_COMP, non-FIXED
// methods take Q24→Hz then get_chan_level_by_method (cmds 20–22).
static inline __attribute__((always_inline)) uint16_t amp_level_q24(int64_t freq_q24, uint8_t osc) {
#ifdef USE_FLOAT_AMP_COMP
  if (amp_comp_method != AMP_COMP_FIXED) {
    float hz = (float)freq_q24 * (1.0f / 16777216.0f);
    return get_chan_level_by_method(hz, osc);
  }
#endif
  int32_t freqFx = (int32_t)((freq_q24 + (1LL << 15)) >> 16);
  return get_chan_level_lookup_fast(freqFx, osc);
}

// Q24 + syncMode switch + 2× lookup. SRAM so vt_chan_level is not a flash caller.
static void __not_in_flash_func(amp_chan_levels_fixed)(int64_t freq_q24_A, int64_t freq_q24_B,
                                                      uint8_t oscA, uint8_t oscB,
                                                      uint16_t *outA, uint16_t *outB) {
  const uint8_t sm = syncMode;
  switch (sm) {
    case 1: {
      int64_t maxAB = (freq_q24_A > freq_q24_B) ? freq_q24_A : freq_q24_B;
      *outA = amp_level_q24(maxAB, oscA);
      *outB = amp_level_q24(freq_q24_B, oscB);
      break;
    }
    case 2: {
      int64_t maxAB = (freq_q24_A > freq_q24_B) ? freq_q24_A : freq_q24_B;
      *outA = amp_level_q24(freq_q24_A, oscA);
      *outB = amp_level_q24(maxAB, oscB);
      break;
    }
    default:
      *outA = amp_level_q24(freq_q24_A, oscA);
      *outB = amp_level_q24(freq_q24_B, oscB);
      break;
  }
}

/**
 * @brief Fast amplitude compensation lookup (Q8 Hz) for fixed path / AMP_COMP_FIXED.
 *
 * Window rule matches float: first i with freqRow[i] <= x < freqRow[i+2].
 * Find: per-osc ampWinCache → walk → full scan (same as FLOAT_QUAD).
 */
uint16_t __not_in_flash_func(get_chan_level_lookup_fast)(int32_t x, uint8_t voiceN) {
  // 1. These arrays were not merged into the struct, so they stay the same
  const int32_t* freqRow = ampCompFrequencyArray[voiceN];
  const int32_t* ampRow  = ampCompArray[voiceN];
  
  // 2. REFACTORED: Get a single pointer to this voice's struct array
  const FixedQuadWindow* winRow = fixedWin[voiceN];

  if (x <= freqRow[0]) {
    BENCH_PATH_INC(amp_clamp);
    return (uint16_t)ampRow[0];
  }

  // Domain ceiling: at/above AMP_COMP_MAX_HZ the cal sentinel is full RANGE.
  // Without this, x == MAX_Q matches no window (exclusive upper bound) and the
  // fallback window-0 path clamps t∈[0,1] to the first segment — ~12k PWM off
  // float, which extrapolates absolute Hz on that window to ~DIV_COUNTER.
  if (x >= AMP_COMP_MAX_HZ_Q) {
    BENCH_PATH_INC(amp_clamp);
    return (uint16_t)DIV_COUNTER;
  }

  // Real plateau only: precompute leaves plateauStartFreqQ at AMP_COMP_MAX_HZ_Q
  // when none was found (same role as plateauStartIndex < 0 in the original code).
  // Do not use plateauStartIndex here — dual-build restores that for the float path.
  if (plateauStartFreqQ[voiceN] < AMP_COMP_MAX_HZ_Q &&
      x >= plateauStartFreqQ[voiceN]) {
    BENCH_PATH_INC(amp_clamp);
    return (uint16_t)DIV_COUNTER;
  }

  const int maxWindow = ampCompTableSize - 2;
  int window = ampWinCache[voiceN];

  if (window >= 0 && window <= maxWindow &&
      x >= freqRow[window] && x < freqRow[window + 2]) {
    BENCH_PATH_INC(amp_hit);
  } else {
    int cand = window;
    if (cand < 0 || cand > maxWindow) cand = 0;
#if defined(BENCH_PATH_STATS)
    uint32_t steps = 0;
#endif
    if (x >= freqRow[cand + 2]) {
      while (cand < maxWindow && x >= freqRow[cand + 2]) {
        ++cand;
#if defined(BENCH_PATH_STATS)
        ++steps;
#endif
      }
    } else if (x < freqRow[cand]) {
      while (cand > 0 && x < freqRow[cand]) {
        --cand;
#if defined(BENCH_PATH_STATS)
        ++steps;
#endif
      }
    }
    if (cand >= 0 && cand <= maxWindow &&
        x >= freqRow[cand] && x < freqRow[cand + 2]) {
      window = cand;
      BENCH_PATH_INC(amp_miss_walk);
#if defined(BENCH_PATH_STATS)
      bench_path_amp_walk_steps(steps);
#endif
    } else {
      window = 0;
      for (int i = 0; i <= maxWindow; ++i) {
        if (x >= freqRow[i] && x < freqRow[i + 2]) {
          window = i;
          break;
        }
      }
      BENCH_PATH_INC(amp_miss_scan);
    }
    ampWinCache[voiceN] = (int16_t)window;
  }

  // 3. REFACTORED: Read math variables directly from the cached struct
  int32_t dx = x - winRow[window].xBase;
  const int32_t span = winRow[window].dx;
  if (dx < 0) dx = 0;
  if (dx > span) dx = span;

  const uint32_t inv_q28 = winRow[window].invDx_q28;
  uint32_t t_q = (uint32_t)(((uint64_t)dx * inv_q28) >> (28 - T_FRAC));

  const int32_t a = winRow[window].aQ_fast;
  const int32_t b = winRow[window].bQ_fast;
  const int32_t c = (int32_t)winRow[window].cQ;

  // Math execution below remains exactly the same as before
  uint32_t t2 = (uint32_t)(((uint32_t)t_q * t_q) >> T_FRAC);
  int32_t term_a, term_b;
  if (amp_quad_muls_i32) {
    term_a = (a * (int32_t)t2) >> T_FRAC;
    term_b = (b * (int32_t)t_q) >> T_FRAC;
  } else {
    term_a = (int32_t)(((int64_t)a * (int64_t)t2) >> T_FRAC);
    term_b = (int32_t)(((int64_t)b * (int64_t)t_q) >> T_FRAC);
  }

  int32_t y_q = term_a + term_b + (c << T_FRAC);
  int32_t y = (y_q + (1 << (T_FRAC - 1))) >> T_FRAC;

  if (y < 0) y = 0;
  if (y > (int32_t)DIV_COUNTER) y = (int32_t)DIV_COUNTER;

  return (uint16_t)y;
}

#ifdef USE_FLOAT_AMP_COMP
/**
 * @brief Pure-float quadratic amp-comp (Hz domain). Live FLOAT_QUAD.
 * Window find: per-osc cache → walk → full scan (first-match [Hz[w], Hz[w+2]]).
 */
uint16_t __not_in_flash_func(get_chan_level_float_quad)(float freqHz, uint8_t voiceN) {
  if (freqHz <= ampCompFrequencyHz[voiceN][0]) {
    BENCH_PATH_INC(amp_clamp);
    return (uint16_t)ampCompArray[voiceN][0];
  }

  // Same domain ceiling as FIXED (see get_chan_level_lookup_fast).
  if (freqHz >= (float)AMP_COMP_MAX_HZ) {
    BENCH_PATH_INC(amp_clamp);
    return (uint16_t)DIV_COUNTER;
  }

  if (plateauStartIndex[voiceN] >= 0) {
    float plateauFreqHz = plateauStartFreqHz[voiceN];
    if (freqHz >= plateauFreqHz) {
      BENCH_PATH_INC(amp_clamp);
      return (uint16_t)DIV_COUNTER;
    }
  }

  const int maxWindow = ampCompTableSize - 2;
  const float *hzRow = ampCompFrequencyHz[voiceN];
  int window = ampWinCache[voiceN];

  if (window >= 0 && window <= maxWindow &&
      freqHz >= hzRow[window] && freqHz < hzRow[window + 2]) {
    BENCH_PATH_INC(amp_hit);
  } else {
    int cand = window;
    if (cand < 0 || cand > maxWindow) cand = 0;
#if defined(BENCH_PATH_STATS)
    uint32_t steps = 0;
#endif
    if (freqHz >= hzRow[cand + 2]) {
      while (cand < maxWindow && freqHz >= hzRow[cand + 2]) {
        ++cand;
#if defined(BENCH_PATH_STATS)
        ++steps;
#endif
      }
    } else if (freqHz < hzRow[cand]) {
      while (cand > 0 && freqHz < hzRow[cand]) {
        --cand;
#if defined(BENCH_PATH_STATS)
        ++steps;
#endif
      }
    }
    if (cand >= 0 && cand <= maxWindow &&
        freqHz >= hzRow[cand] && freqHz < hzRow[cand + 2]) {
      window = cand;
      BENCH_PATH_INC(amp_miss_walk);
#if defined(BENCH_PATH_STATS)
      bench_path_amp_walk_steps(steps);
#endif
    } else {
      window = 0;
      for (int i = 0; i <= maxWindow; ++i) {
        if (freqHz >= hzRow[i] && freqHz < hzRow[i + 2]) {
          window = i;
          break;
        }
      }
      BENCH_PATH_INC(amp_miss_scan);
    }
    ampWinCache[voiceN] = (int16_t)window;
  }

  // REFACTORED: Access a, b, and c directly from the floatCoeffs struct
  const FloatQuadCoeffs& coeff = floatCoeffs[voiceN][window];

  float interpolatedValue = (coeff.a * freqHz + coeff.b) * freqHz + coeff.c;
  return (uint16_t)round(interpolatedValue);
}

uint16_t __not_in_flash_func(get_chan_level_lut)(float freqHz, uint8_t voiceN) {
  if (freqHz <= 0.0f) return ampCompLut[voiceN][0];
  if (freqHz >= (float)AMP_COMP_MAX_HZ) return ampCompLut[voiceN][AMP_COMP_MAX_HZ];
  // Nearest integer Hz (not trunc) — same single table load, lower quantize bias.
  // Stay off LUT[MAX] until the hard clamp above: rounding 6999.75→7000 would
  // return the plateau bin while float is still on the last window (~200 counts).
  int32_t hz = (int32_t)(freqHz + 0.5f);
  if (hz < 0) hz = 0;
  if (hz >= AMP_COMP_MAX_HZ) hz = AMP_COMP_MAX_HZ - 1;
  return ampCompLut[voiceN][hz];
}
#endif  // USE_FLOAT_AMP_COMP

// Map raw PW counter into calibrated center/limits for one oscillator. Used on the 99 µs PW path.
inline uint16_t get_PW_level_interpolated(uint16_t PWval, uint8_t oscN) {

  uint16_t chanLevel;

  // Horizontal PW axis: 0 .. DIV_COUNTER_PW-1 (pot/LFO/ADSR domain)
  // Vertical axis (output): mapped to calibrated low/center/high PWM limits.

  if (PWval >= (DIV_COUNTER_PW - 1)) {
    // Above max PW, clamp to calibrated high limit.
    return PW_HIGH_LIMIT[oscN];
  } else if (PWval <= 0) {
    // Below min PW, clamp to calibrated low limit.
    return PW_LOW_LIMIT[oscN];
  } else {
    uint16_t pwLowBreak  = PW_LOOKUP[0];  // usually 0
    uint16_t pwMidBreak  = PW_LOOKUP[1];  // mid-point
    uint16_t pwHighBreak = PW_LOOKUP[2];  // usually DIV_COUNTER_PW-1

    if (PWval >= pwMidBreak) {
      // Upper half: interpolate from center to high limit.
      chanLevel = map(PWval,
                      pwMidBreak, pwHighBreak,
                      PW_CENTER[oscN], PW_HIGH_LIMIT[oscN]);
    } else {
      // Lower half: interpolate from low limit to center.
      chanLevel = map(PWval,
                      pwLowBreak, pwMidBreak,
                      PW_LOW_LIMIT[oscN], PW_CENTER[oscN]);
    }

    return chanLevel;
  }
}

// Drive one oscillator for calibration measurement (manual cal and nested auto-cal probes).
void voice_task_autotune(uint8_t taskAutotuneVoiceMode, uint16_t calibrationValue) {

  float freq;
  uint8_t note1;  // = 57;
  int chanLevel = ampCompCalibrationVal;

  if (VOICE_NOTES[0] > 0) {
    note1 = VOICE_NOTES[0] - 12;
  }

  if (taskAutotuneVoiceMode == 4) {
    // Highest-frequency search drives an explicit frequency instead of a note.
    freq = calibrationFreqHz;
  } else {
    freq = (float)sNotePitches[note1];
  }

  // Target period in cycles for the calibration tone. Guarded because freq can be 0,
  // which would make the float division infinite and the cast undefined.
  uint32_t autotune_total_cycles =
      (freq > 0.0f) ? (uint32_t)fminf(((float)sysClock_Hz / freq) + 0.5f, 4.0e9f) : 0u;

  if (manualCalibrationFlag == true) {  // One Ocillator at a time to get correct gap

    uint8_t currentCalibrationOscillator = cal_manual_osc();

    // ALL AT ONCE
    for (int i = 0; i < NUM_OSCILLATORS; i++) {
      PIO pioN = pio[VOICE_TO_PIO[i]];
      uint8_t sm1N = VOICE_TO_SM[i];

      if (i != currentCalibrationOscillator) {
        // Parked at a clk_div the SM keeps toggling RESET; only a stopped one is
        // really silent. pio_sm_exec runs on a stopped SM, so the pull still
        // drains what was put (same idiom as osc_load_period_stopped).
        pio_sm_set_enabled(pioN, sm1N, false);
        pio_sm_put(pioN, sm1N, 0);
        pio_sm_exec(pioN, sm1N, pio_encode_pull(false, false));
        write_range_pwm((uint8_t)i, 0);
      } else {
        pio_sm_set_enabled(pioN, sm1N, true);  // an earlier stage may have stopped it

        uint32_t clk_div1 = autotune_total_cycles
                              ? pio_clk_div_for_y(autotune_total_cycles, osc_last_y[i],
                                                  osc_ramp_weight(i), osc_period_overhead(i))
                              : 0u;

        pio_sm_put(pioN, sm1N, clk_div1);

        pio_sm_exec(pioN, sm1N, pio_encode_pull(false, false));

        write_range_pwm((uint8_t)i, calibrationValue);

        //Serial.println((String) "currentCalibrationOscillator: " + (int)currentCalibrationOscillator + (String) "   calibrationValue: " + (int)calibrationValue);
      }
    }

    // The pulse is the one wave with no analog switch, so its PW CV is its
    // on/off and every channel has to be written: one left at the value the
    // panel gave it keeps that voice sounding through the whole walk. The
    // calibrated voice opens only on the pulse / 440 substages, at the same
    // PW center every FREQ_TRACE anchor probe measures at, so an ampComp440
    // dialled by ear is not offset from what the trace later finds.
    {
      const uint8_t pwCh = cal_pw_channel(currentCalibrationOscillator);
      const bool wantPulse = cal_stage_is_square((uint8_t)manualCalibrationStage);
      for (uint8_t ch = 0; ch < NUM_PW_CHANNELS; ch++) {
        uint16_t pwLevel = 0;
        if (wantPulse && ch == pwCh) {
          pwLevel = (PW_CENTER[ch] != 0) ? PW_CENTER[ch]
                                         : (uint16_t)(DIV_COUNTER_PW / 2);
        }
        voice_write_pw(ch, pwLevel);
      }
    }
  } else {

    PIO pioN = pio[VOICE_TO_PIO[currentDCO]];
    uint8_t sm1N = VOICE_TO_SM[currentDCO];

    uint32_t clk_div1 = autotune_total_cycles
                          ? pio_clk_div_for_y(autotune_total_cycles, osc_last_y[currentDCO],
                                              osc_ramp_weight(currentDCO),
                                              osc_period_overhead(currentDCO))
                          : 0u;

    pio_sm_put(pioN, sm1N, clk_div1);
    pio_sm_exec(pioN, sm1N, pio_encode_pull(false, false));

    switch (taskAutotuneVoiceMode) {
      case 0:
      case 4:
        write_range_pwm(currentDCO, calibrationValue);
        break;
      case 2:
        write_range_pwm(currentDCO, chanLevel);
        break;
      case 3:
        chanLevel = get_chan_level_for_engine(freq, currentDCO);
        write_range_pwm(currentDCO, chanLevel);
        break;
    }

    //}
    // Serial.println((String) "| currentDCO: " + currentDCO + (String) " | freq: " + freq + (String) " | clk_div1: " + clk_div1 + (String) " | ampCompCalibrationVal: " + ampCompCalibrationVal);
  }
}

// Cached variant: pass DCO index to reuse last segment and avoid binary search
#if PITCH_INTERP_MODE == PITCH_INTERP_Q12
int32_t __not_in_flash_func(interpolatePitchMultiplierIntQ16_cached)(int32_t xQ16, int dcoIndex) {
  int32_t xInt = xQ16 >> 16;
  if (xInt <= xMultiplierTable[0]) {
    return yMultiplierTable[0];
  }
  if (xInt >= xMultiplierTable[multiplierTableSize - 1]) {
    return yMultiplierTable[multiplierTableSize - 1];
  }
  int low = interpSegCache[dcoIndex];
  if (low < 0 || low > multiplierTableSize - 2 || !(xMultiplierTable[low] <= xInt && xInt < xMultiplierTable[low + 1])) {
    if (low >= 0 && low < multiplierTableSize - 1) {
      if (xInt >= xMultiplierTable[low + 1]) {
        while (low < multiplierTableSize - 2 && xInt >= xMultiplierTable[low + 1]) low++;
      } else if (xInt < xMultiplierTable[low]) {
        while (low > 0 && xInt < xMultiplierTable[low]) low--;
      }
    }
    if (!(low >= 0 && low < multiplierTableSize - 1 && xMultiplierTable[low] <= xInt && xInt < xMultiplierTable[low + 1])) {
      int l = 0, h = multiplierTableSize - 1;
      while (l <= h) {
        int m = (l + h) >> 1;
        if (xMultiplierTable[m] <= xInt && xInt < xMultiplierTable[m + 1]) {
          low = m;
          break;
        } else if (xInt < xMultiplierTable[m]) {
          h = m - 1;
        } else {
          l = m + 1;
        }
      }
      if (low < 0) low = 0;
      if (low > multiplierTableSize - 2) low = multiplierTableSize - 2;
    }
    interpSegCache[dcoIndex] = (int16_t)low;
  }
  int32_t x0 = xMultiplierTable[low];
  int32_t y0 = yMultiplierTable[low];
  int32_t deltaQ12 = (xQ16 - (x0 << 16)) >> 4;
  int32_t y = y0 + (int32_t)((((int64_t)deltaQ12 * (int64_t)slopeQ12[low]) + (1LL << 23)) >> 24);
  return y;
}
#endif // Q12

#if PITCH_INTERP_MODE == PITCH_INTERP_RATIO_Q16
// xQ16 and tables are natural Q16 (1.0 = 65536). Returns frequency ratio as Q16.
// Miss path: O(1) trunc±1 (same idea as FLOAT_FAST) — avoids walk under LFO thrash.
int32_t __not_in_flash_func(interpolateRatioQ16_cached)(int32_t xQ16, int dcoIndex) {
  // Endpoints match initMultiplierTables (-1 / 3) in Q16.
  static constexpr int32_t kPitchX0_Q16 = -65536; // -1.0
  static constexpr int32_t kPitchX1_Q16 = 196608; // 3.0
  if (xQ16 <= kPitchX0_Q16) {
    BENCH_PATH_INC(ratio_clamp);
    return yMultiplierTable[0];
  }
  if (xQ16 >= kPitchX1_Q16) {
    BENCH_PATH_INC(ratio_clamp);
    return yMultiplierTable[multiplierTableSize - 1];
  }
  const int lastSeg = multiplierTableSize - 2;
  int low = interpSegCache[dcoIndex];
  if (low >= 0 && low <= lastSeg &&
      xMultiplierTable[low] <= xQ16 && xQ16 < xMultiplierTable[low + 1]) {
    BENCH_PATH_INC(ratio_hit);
  } else {
    // cand ≈ (x - (-1)) * (N/4); N=200 → *50, then >>16 for Q16.
    static constexpr int kPitchInvDx = multiplierTableSize / 4; // 50
    int cand = (int)(((int64_t)(xQ16 - kPitchX0_Q16) * (int64_t)kPitchInvDx) >> 16);
    if (cand < 0) cand = 0;
    else if (cand > lastSeg) cand = lastSeg;
#if defined(BENCH_PATH_STATS)
    uint32_t steps = 0;
#endif
    if (cand < lastSeg && xQ16 >= xMultiplierTable[cand + 1]) {
      ++cand;
#if defined(BENCH_PATH_STATS)
      steps = 1;
#endif
    } else if (cand > 0 && xQ16 < xMultiplierTable[cand]) {
      --cand;
#if defined(BENCH_PATH_STATS)
      steps = 1;
#endif
    }
    low = cand;
    BENCH_PATH_INC(ratio_miss_direct);
#if defined(BENCH_PATH_STATS)
    bench_path_walk_steps(steps);
#endif
    interpSegCache[dcoIndex] = (int16_t)low;
  }
  const int32_t x0 = xMultiplierTable[low];
  const int32_t y0 = yMultiplierTable[low];
  const int32_t delta = xQ16 - x0;
  // slopeQ16 = (dy << 16) / dx  →  y = y0 + (delta * slope) >> 16
  // Boot proves |delta_max*slope| fits int32 (Q20 product does not).
  return y0 + (((delta * slopeQ16[low]) + (1 << 15)) >> 16);
}
#endif // PITCH_INTERP_RATIO_Q16

#if PITCH_INTERP_MODE == PITCH_INTERP_FLOAT
// x = pitch modifier in ~[-1, 3]; returns frequency ratio directly (tables are unscaled).
// Walk + bsearch find (A/B vs FLOAT_FAST).
float __not_in_flash_func(interpolateRatioFloat_cached)(float x, int dcoIndex) {
  if (x <= xMultiplierTableF[0]) {
    BENCH_PATH_INC(ratio_clamp);
    return yMultiplierTableF[0];
  }
  if (x >= xMultiplierTableF[multiplierTableSize - 1]) {
    BENCH_PATH_INC(ratio_clamp);
    return yMultiplierTableF[multiplierTableSize - 1];
  }

  int low = interpSegCache[dcoIndex];
  if (low >= 0 && low <= multiplierTableSize - 2 &&
      xMultiplierTableF[low] <= x && x < xMultiplierTableF[low + 1]) {
    BENCH_PATH_INC(ratio_hit);
  } else {
#if defined(BENCH_PATH_STATS)
    uint32_t steps = 0;
#endif
    if (low >= 0 && low < multiplierTableSize - 1) {
      if (x >= xMultiplierTableF[low + 1]) {
        while (low < multiplierTableSize - 2 && x >= xMultiplierTableF[low + 1]) {
          ++low;
#if defined(BENCH_PATH_STATS)
          steps++;
#endif
        }
      } else if (x < xMultiplierTableF[low]) {
        while (low > 0 && x < xMultiplierTableF[low]) {
          --low;
#if defined(BENCH_PATH_STATS)
          steps++;
#endif
        }
      }
    }
    if (!(low >= 0 && low < multiplierTableSize - 1 &&
          xMultiplierTableF[low] <= x && x < xMultiplierTableF[low + 1])) {
      int l = 0;
      int h = multiplierTableSize - 1;
      while (l <= h) {
        int m = (l + h) >> 1;
        if (xMultiplierTableF[m] <= x && x < xMultiplierTableF[m + 1]) {
          low = m;
          break;
        } else if (x < xMultiplierTableF[m]) {
          h = m - 1;
        } else {
          l = m + 1;
        }
      }
      if (low < 0) low = 0;
      if (low > multiplierTableSize - 2) low = multiplierTableSize - 2;
      BENCH_PATH_INC(ratio_miss_bsearch);
    } else {
      BENCH_PATH_INC(ratio_miss_direct);
#if defined(BENCH_PATH_STATS)
      bench_path_walk_steps(steps);
#endif
    }
    interpSegCache[dcoIndex] = (int16_t)low;
  }

  return yMultiplierTableF[low] + slopeF[low] * (x - xMultiplierTableF[low]);
}
#endif // PITCH_INTERP_FLOAT

#if PITCH_INTERP_MODE == PITCH_INTERP_FLOAT_FAST
// Trunc+clamp±1 find; same lerp as walk. Keep ±1 even when walk_steps≈0 (live ballast).
// noinline: isolate codegen from voice_task_float (distinct SRAM symbol).
__attribute__((noinline))
float __not_in_flash_func(interpolateRatioFloat_cached_fast)(float x, int dcoIndex) {
  // Endpoints match initMultiplierTables (-1 / 3).
  if (x <= -1.0f) {
    BENCH_PATH_INC(ratio_clamp);
    return yMultiplierTableF[0];
  }
  if (x >= 3.0f) {
    BENCH_PATH_INC(ratio_clamp);
    return yMultiplierTableF[multiplierTableSize - 1];
  }

  static constexpr float kPitchX0 = -1.0f;
  static constexpr float kPitchInvDx = (float)multiplierTableSize / 4.0f; // N/4 = 50
  const int lastSeg = multiplierTableSize - 2;

  int low = interpSegCache[dcoIndex];
  if (low >= 0 && low <= lastSeg &&
      xMultiplierTableF[low] <= x && x < xMultiplierTableF[low + 1]) {
    BENCH_PATH_INC(ratio_hit);
  } else {
    int cand = (int)((x - kPitchX0) * kPitchInvDx);
    if (cand < 0) cand = 0;
    else if (cand > lastSeg) cand = lastSeg;
    // Float rounding / live ballast: keep both ±1 compares even if steps stay 0.
#if defined(BENCH_PATH_STATS)
    uint32_t steps = 0;
#endif
    if (cand < lastSeg && x >= xMultiplierTableF[cand + 1]) {
      ++cand;
#if defined(BENCH_PATH_STATS)
      steps = 1;
#endif
    } else if (cand > 0 && x < xMultiplierTableF[cand]) {
      --cand;
#if defined(BENCH_PATH_STATS)
      steps = 1;
#endif
    }
    low = cand;
    BENCH_PATH_INC(ratio_miss_direct);
#if defined(BENCH_PATH_STATS)
    bench_path_walk_steps(steps);
#endif
    interpSegCache[dcoIndex] = (int16_t)low;
  }

  return yMultiplierTableF[low] + slopeF[low] * (x - xMultiplierTableF[low]);
}
#endif // PITCH_INTERP_FLOAT_FAST

// Build integer/float pitch-multiplier tables and slopes (boot). Called from init_voices().
void initMultiplierTables() {

  float y_value;
  double divisor = multiplierTableSize;
  double fraction = 4.00d / divisor;

  for (int i = 0; i < multiplierTableSize; i++) {
    double x;

    if (i == 0) {
      x = -1.00d;
      y_value = 0.25d;
    } else if (i == multiplierTableSize - 1) {
      x = 3.0d;
      y_value = 4.0d;
    } else {
      x = (-1.00d + (fraction * (double)i));
      y_value = expInterpolationSolveY(x + 1.00d, 1.00d, 3.00d, 0.50d, 2.00d);
    }

#if PITCH_INTERP_MODE == PITCH_INTERP_FLOAT || \
    PITCH_INTERP_MODE == PITCH_INTERP_FLOAT_FAST
    // Natural domain: x = modifier [-1,3], y = frequency ratio (no int-table scale).
    xMultiplierTableF[i] = (float)x;
    yMultiplierTableF[i] = y_value;
#elif PITCH_INTERP_MODE == PITCH_INTERP_RATIO_Q16
    // Native Q16: x and y store natural units (1.0 = 65536). No ×10000.
    xMultiplierTable[i] = (int32_t)(x * 65536.0 + (x >= 0.0 ? 0.5 : -0.5));
    yMultiplierTable[i] = (int32_t)((double)y_value * 65536.0 + 0.5);
    x0Q16_tbl[i] = xMultiplierTable[i];
#else
    // Q12 A/B: legacy ×10000 table-units.
    xMultiplierTable[i] = (int32_t)(x * (double)multiplierTableScale);
    yMultiplierTable[i] = (int32_t)(y_value * (double)multiplierTableScale);
    x0Q16_tbl[i]        = xMultiplierTable[i] << 16;
#endif
  }

#if PITCH_INTERP_MODE == PITCH_INTERP_RATIO_Q16
  // Q20×(dx-1) overflows int32 on upper segments (~7.5e9). Q16 matches Q20 y on
  // this 200-knot set and keeps |delta*slope| in signed 32-bit for MULS lerp.
  for (int i = 0; i < (multiplierTableSize - 1); ++i) {
    int32_t dx = xMultiplierTable[i + 1] - xMultiplierTable[i];
    if (dx == 0) dx = 1;
    int32_t dy = yMultiplierTable[i + 1] - yMultiplierTable[i];
    int64_t numSlope = ((int64_t)dy << 16) + (dx > 0 ? dx / 2 : -dx / 2);
    slopeQ16[i] = (int32_t)(numSlope / (int64_t)dx);
    const int32_t delta_max = (dx > 0) ? (dx - 1) : 0;
    const int64_t prod = (int64_t)delta_max * (int64_t)slopeQ16[i];
    // One-time boot proof only (no live branch). Stock table always fits.
    if (prod > (int64_t)INT32_MAX || prod < (int64_t)INT32_MIN) {
#if defined(RUNNING_AVERAGE)
      bench_out_printf("ratio slopeQ16*delta overflows int32 at seg %d\n", i);
#endif
    }
  }
#elif PITCH_INTERP_MODE == PITCH_INTERP_Q12
  for (int i = 0; i < (multiplierTableSize - 1); ++i) {
    int32_t dx = xMultiplierTable[i + 1] - xMultiplierTable[i];
    if (dx == 0) dx = 1;
    int32_t dy = yMultiplierTable[i + 1] - yMultiplierTable[i];
    int64_t numSlope12 = ((int64_t)dy << 12) + (dx > 0 ? dx / 2 : -dx / 2);
    slopeQ12[i] = (int32_t)(numSlope12 / (int64_t)dx);
  }
#elif PITCH_INTERP_MODE == PITCH_INTERP_FLOAT || \
      PITCH_INTERP_MODE == PITCH_INTERP_FLOAT_FAST
  for (int i = 0; i < multiplierTableSize - 1; ++i) {
    float dxF = xMultiplierTableF[i + 1] - xMultiplierTableF[i];
    if (dxF == 0.0f) dxF = 1.0f;
    slopeF[i] = (yMultiplierTableF[i + 1] - yMultiplierTableF[i]) / dxF;
  }
#endif

  for (int d = 0; d < NUM_OSCILLATORS; ++d) interpSegCache[d] = -1;
}
