felipegaspari/DCO4-REBORN-DCO/(commit log)

2025-11-24 auto calibration algorithm improvements
2026-07-28 AI documentation added
    [Serial_comms_and_params_reference.txt]
2026-07-31 new pio sync modes and corrections
    [globals.h, params.ino, state_machines.h, state_machines.ino, voices.ino]
2026-07-31 midi CC parameter implementation and open stage control integration
2026-08-01 better dco control tools, better benchmarking, distortion prototype
2026-08-01 better dco control tools, better benchmarking, distortion prototype, dual filter prototype, aux rp2040 board
    [distortion.kicad_sch]
2026-08-03 better benchmarking, performance fixes
    [DCO.ino, PWM.ino, adsr.ino, amp_comp_bench.ino, globals.h, mod_matrix.ino, params.ino]
2026-08-03 Wire ADSR_Bezier via symlink to monorepo root library.
    Replace the compile stub with a symlink to ../../ADSR_Bezier (main)
    and document vendored libraries for monorepo and standalone clones.
2026-08-03 Expose ADSR_BEZIER_USE_FLOAT toggle for dual-backend ADSR library.
    Default fixed-point envelope path; document toggle in README and REFERENCE_AI.
    [adsr.h]
2026-08-05 many untested changes. performance and fixes, as well as broken things: portamento 1st time on glitch, mo-lfo sine is steppy and waform phases are misaligned, etc
    [DCO.ino, PWM.ino, Serial.ino, adsr.h, globals.h, midi.ino, params.ino]
2026-08-07 many untested changes. added noise generators, 4 different engines. cv_update improved performance . fixed multiple note press bug. other performance and fixes, as well as broken things: portamento 1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
    [DCO.ino, PWM.ino, cv_out.ino, cv_state.h, globals.h, include_all.h]
2026-08-08 PIO PWM RANGE DITHER - 3 FRAMES, several fixes
    [DCO.ino, PWM.ino, Timer_micros.h, Timer_micros.ino, cv_out.ino, globals.h, include_all.h]
2026-08-09 MORE Q15, more fixes, incredible SRAM pinning performance upgrade
    [Serial_comms_and_params_reference.txt]
2026-08-09 MORE Q15, more fixes, incredible SRAM pinning performance upgrade. pitch env centered option
    [Serial.h, Serial.ino, adsr.h, params.ino, serial_protocol.h, voices.ino]
2026-08-11 calibration wip. project unification
2026-08-11 Add sketch-root shims for DCO-PROTOCOL (Arduino IDE)
    Arduino IDE never gets --libraries ./_build_libs, so bare #include
    "params_def.h" failed after the headers moved into the shared library.
    These one-line shims forward into _build_libs/DCO-PROTOCOL; nested includes
    still resolve next to the real files.
2026-08-12 Send EnvDCO to the Mainboard so the panel can follow it
    The envelope runs on this board and drives no Mainboard CV, which is why 'c'
    never went out. But the faders that set it live on the panel, so a host edit,
    a MIDI CC or a preset recall left them stale. The block now crosses purely to
    be relayed.
2026-08-12 calibration heaven !!! project unification
2026-08-12 calibration heaven !!! project unification. docs updating and cleaning
2026-08-13 board type definitions
